Dendy3CTD/NeuroPaw/analysis_v6.md

# NeuroPaw v6 — Этап 0: анализ robodog_v3.blend

Скрипт: `scripts/v6_00_inventory.py`, сырой вывод: `analysis_v6_raw.txt`,
рендеры: `renders/v6_before_{front,side,top,iso}.png`.

## Что есть
- 87 объектов: 62 меша, 25 пустышек. Коллекции: Body (6), Electronics (6), Head (9),
  Leg_FL/FR/RL/RR (по 10), Rig (25). Арматуры нет, камеры и света нет, движок EEVEE.
  Единицы — метры, масштаб 1.
- 12 × MG996R на ногах: отведение (ось X, серва в корпусе), бедро (ось Y, в кронштейне),
  колено (в бедре, привод голени через качалку, тягу и рычаг, параллелограмм).
  Вал каждой сервы совпадает с осью сустава.
- Риг на пустышках: `*_shoulder → *_hip → *_knee`. Качалка копирует угол колена,
  тяга сделана через Stretch To. Ограничений хода нет.
- Стойка: бедро 44.7°, колено −84.8°. Стопы под осями бёдер на Z = 10 мм,
  пересечений между звеньями нет. Габарит 432 × 231 × 279 мм.
- Корпус 260×110×60 из 6 пластин с фаской. Электроника — коробки:
  2S 140×45×25, ESP32-S3, 1 × PCA9685, UBEC, IMU.
- Голова статичная: глаза GC9A01, камера IMX219, VL53L5CX, уши без привода.
- 14 простых Principled-материалов.

## Чего не хватает до 20 сервоприводов
| №  | Узел | В v3 |
|----|---|---|
| 01–12 | ноги | есть, но надо переименовать (RL/RR → BL/BR, `Servo_NN_*`) и детализировать |
| 13–14 | позвоночник pitch / yaw | нет: корпус цельный |
| 15–16 | шея pitch / yaw | нет: голова прикручена к крышке |
| 17 | челюсть | нет, морда цельная |
| 18–19 | уши | уши есть, но без серв |
| 20 | хвост | нет |

## Инженерные проблемы
1. **Валы несут изгиб.** Ни на одном суставе нет второй опоры. Бедро висит на валу
   сервы бедра консолью, у кронштейна плеча нет подшипника, ось рычага колена
   проходит сквозь щёки без подшипников.
2. **Мёртвая точка колена.** Механизм колена — параллелограмм. Он вырождается, когда
   нога выпрямлена (угол 0° — это край хода 0–130°). Нужен четырёхзвенник с разными
   плечами или смещённая фаза, чтобы угол передачи во всём ходе был не меньше 30°.
3. **Корпус мал.** Плечевая MG996R с ушками (54.5 мм) входит в корпус высотой 60
   с зазором 0.25 мм, а требование — 0.3 мм посадки. Туда же не помещаются
   Pi 5 с кулером, второй PCA9685, DC-DC, отсек батареи и узел позвоночника.
   Корпус придётся увеличить, см. вопрос 2.
4. Кронштейн сервы бедра держит её только сверху и спереди. Качалки нейлоновые,
   а не 25T алюминиевые. Нет упоров, термовставок, винтов, скруглений.
5. Сервы — коробка с цилиндром: нет шлицов, наклейки и выхода провода. Нет MG90S/SG90.
6. Нет проводов, кабельных каналов, выключателя, XT60, DC-DC.
7. `weight_report.txt` относится к v2, ошибка в моментах колена и бедра не исправлена.
   Массы v3 и центр масс не считались.

## Визуальные проблемы
- Всё собрано из коробок: оболочки и накладок нет, голова — куб, уши — пластинки.
- Нет панельных линий, крепежа, протектора, логотипа. Материалы-заглушки, EEVEE без
  света и камеры, рендер плоский.

---

# Изменение архитектуры (27.10.2026): 4 × ESP32-S3 + CAN

Jetson Orin Nano и Raspberry Pi 5 убраны. Документы обновлены: `project.txt`, `params.json`
(старый — `params_v3.json`, его читает `build_v3.py`).

## Платы
| Плата | Модуль | Где | Что подключено |
|---|---|---|---|
| ESP32_Body | ESP32-S3-DevKitC-1 N16R8, 63×25.4 мм | задняя секция, над АКБ | PCA9685 0x40 (сервы 01–14, 20), BNO085, INA226 (ток серв + напряжение АКБ), CAN-терминатор |
| ESP32_Brain | ESP32-S3-DevKitC-1 N16R8 | передняя секция, у дна | microSD 64 ГБ (SPI, лючок на левом боку), CAN |
| ESP32_Comms | XIAO ESP32S3 + FPC-антенна | передняя секция, под крышкой | Wi-Fi/BLE; антенна под крышкой из PETG, вдали от серво-жгутов |
| ESP32_Head | XIAO ESP32S3 Sense (OV2640, PDM-микрофон) | в голове за лицевой панелью | PCA9685 0x41 (сервы 15–19), MAX98357A, 2 кольца WS2812B, VL53L5CX, 3 × TTP223, CAN-терминатор |

**Голова: XIAO Sense + PCA9685, а не DevKitC и не прямой PWM.**
- Камера и микрофон уже стоят на плате. DevKitC (63×25 мм) не помещается за лицом
  вместе с камерой, а камеру к нему пришлось бы вести 16 проводами.
- У XIAO 11 GPIO. Уже заняты: I2C (2), CAN (2), I2S динамика (3), лента глаз (1),
  то есть 8. Пять PWM для серв не помещаются.
- PCA9685 сидит на той же шине I2C, что и ToF, ему не нужны лишние пины. Его PWM
  аппаратный и не дрожит, когда процессор занят камерой и Wi-Fi.
- Глаза — светодиодные кольца WS2812B на одном пине вместо двух дисплеев GC9A01:
  тем на SPI нужно 5–6 пинов.

**IMU** стоит в задней секции у узла позвоночника (x ≈ −31 мм). Центр масс по оценке
на x ≈ +2 мм, это сам узел позвоночника, а он подвижный. Поэтому IMU на ближайшей
жёсткой секции, и I2C не пересекает изгиб.

## Корпус: 270 × 120 × 70 мм вместо 300 × 120 × 75
- Две секции по 120 мм и зазор 30 мм под узел позвоночника.
  - Pitch: серва 13 в задней секции, ось Y на x = −27.
  - Yaw: серва 14 на вилке, ось Z на x = +18.
- Зазора 30 мм хватает на ±20° pitch и ±15° yaw: при yaw ±15° угол передней секции
  подходит к задней на ≈ 15 мм.
- Ширина 120: аккумулятор 67 мм встаёт между плечевыми сервами (оси ±45 мм).
- Высота 70: плечевая MG996R с ушками (54.5 мм) входит с зазором ≥ 0.3 мм, внутри 64 мм.
- Ось бедра на Z = 175, спина на 220 мм, как в v3. Расстояние между бёдрами 220 мм.
- Аккумулятор 2S 6000 мА·ч — сборка **2S2P 18650** (76×67×20, 200 г) в отсеке снизу
  задней секции. Обычная LiPo 2S 6000 (138×47×25) не помещается в секцию 120 мм.

## Предварительная оценка (`docs/estimate_v6_prelim.md`)
- Масса ≈ **2.59 кг**, центр масс по X ≈ **+2 мм**.
- ⚠ **Колени MG996R не тянут стойку на трёх ногах**: нужно 10.5 кг·см, есть 9.4,
  запас 0.9. Рекомендация — **DS3218MG** на 03/06/09/12, запас 1.9, посадка та же.
  Вставать нужно, ставя стопу между бедром и коленом (запас 2.0). Если ставить стопу
  под бедро, запас 1.0.
- Остальные суставы с запасом ≥ 1.7.
- ⚠ Пиковый ток серв ≈ **25.7 А** — на пределе UBEC 25 А. Вставать нужно с разносом
  по времени (ноги по очереди) или брать UBEC 30 А.
- ⚠ Логика 5 В: пик ≈ **2.8 А**, а не 1–1.5 А. Основной вклад — LED-глаза и динамик.
  Глаза нужно ограничить ≤ 30 % яркости, иначе DC-DC 5 В 5 А.
- Время работы: ходьба ≈ 41 мин, стоит ≈ 78 мин, лежит ≈ 5.8 ч.

## Обновлённый план
- **Этап 1.** Модель v6 с нуля по параметрам (`scripts/build_v6.py`, логика v3):
  - две секции и позвоночник, 20 сервоприводов в коллекции Servos/{MG996R,MG90S,SG90};
  - шея, голова с челюстью, уши, хвост;
  - платы с понятными именами в Electronics/{Body,Head,Brain,Comms,Power}.
- **Этапы 2–6** — как в плане выше. Добавляются:
  - цвет «управляющая плата» в Servo_map;
  - рендер `v6_nervous_system.png`;
  - документы `docs/nervous_system.md`, `servo_map.md` (столбец «плата»), `bom.md`.

---

# Этап 1 — итог (robodog_v6.blend)

Сборка: `blender --background --python scripts/build_v6.py`. Модули — `scripts/v6lib/`:
`layout` (размеры, оси, таблица серв), `servo` (модели), `rig` (арматура), `parts_*`,
`cable`, `checks`. Рендеры: `renders/v6_s1_*.png`, `renders/v6_servo_types.png`.

- **20 сервоприводов**: MG996R × 15, MG90S × 1, SG90 × 4, коллекции `Servos/<тип>`.
  У каждой сервы custom properties: №, тип, сустав, ход, плата, PCA9685, канал, момент,
  масса, `shaft_sign` (направление вала относительно оси кости).
- **Модель сервы**: корпус, ушки со щелью, купол редуктора, шлицевой вал (25T/20T/21T),
  наклейка, выход провода из трёх жил с изгибом. Цвет по типу.
- **Арматура `NeuroPaw_rig`**: 29 костей — 20 суставов + Root + 8 MCH для тяги колена.
  Ось кости — локальная Y = ось вала.
- **Корпус** из двух секций с окнами под узел позвоночника. Серва 13 (pitch) в задней
  секции, серва 14 (yaw) в вилке. Шея: 15 в основании на крышке, 16 на звене шеи.
  Челюсть 17, уши 18/19, хвост 20.
- **Электроника** в `Electronics/{Body,Brain,Comms,Head,Power,CAN}`:
  - платы ESP32_Body, ESP32_Brain, ESP32_Comms, ESP32_Head и CAN_transceiver_* × 4;
  - microSD_slot у люка на левом боку;
  - `CAN_bus_cable` — трубка, гнётся вместе с арматурой.
- **Проверки (стойка)**:
  - пересечений между деталями 0;
  - стопы на полу (низ Z = 0.5 мм), тяги не меняют длину;
  - угол передачи колена ≥ 25° на всём ходе 0–130°, мёртвой точки нет;
  - габарит 421 × 241 × 373 мм.

**Риски к этапам 3 и 5**
- Отведение внутрь: при −30° щека бедра упирается в боковую стенку корпуса.
- Бедро ±90°: кронштейн плеча и кронштейн сервы бедра ограничивают ход.

Реальные пределы измерю перебором поз на этапе 5 и поставлю упоры.

---

# Решение по коленям, электронике и питанию — статус (прервано лимитом)

**Сделано**
- `scripts/v6_knee_linkage.py` → `docs/knee_linkage.md`, `params.json["knee_linkage"]`.
  - Геометрия B: качалка 15 мм, рычаг 29 мм, тяга 55 мм, β = 38°, вал сервы на оси бедра.
  - Ход колена 65–130° при ходе сервы 155°.
  - Передача 2.09 в стойке, ≥ 1.93 на шаге. Угол передачи ≥ 31°.
  - Запас колена ≥ 1.9 во всех позах, включая рысь ×1.3 и вставание из «лежит».
  - Поза «сидит» по-собачьи (κ 145°) несовместима с передачей 1.8:
    - до 145° — только передача 1.46 при качалке 18 мм (вариант C2);
    - до 140° — передача 1.66.
    - Выбран вариант B; «сидит» — неглубокая посадка с упором таза + позвоночник.
- `params.json` переписан:
  - `servo_table` — 20 серв по новой таблице;
  - DS3235MG, MG996R 11 кг·см;
  - подшипники: 6802ZZ × 6, F625ZZ × 12;
  - электроника: Brain = XIAO Sense в голове, Senses = DevKitC в голове;
  - питание: P28A 5600 мА·ч, 2 × UBEC 20 А, DC-DC 5 А;
  - цепочка CAN: Senses — Brain — Comms — Body;
  - адреса I2C, заполнение 22 %.

**Осталось (в этом порядке)**
1. `v6lib/layout.py`:
   - брать таблицу серв из `params.json["servo_table"]`;
   - переименовать кости (13 yaw — ребёнок 14 pitch; 15 хвост, 16–20 голова);
   - SH_X = 129, HIP_Y0 = 70.
2. `servo.py` + `parts.py`: тип DS3235MG (тёмно-серый), коллекция Servos/DS3235MG.
3. `parts_leg.py`:
   - четырёхзвенник: драйвер угла качалки (simple expression atan2/acos по углу колена), тяга Stretch To;
   - Limit Rotation на костях;
   - подшипники (6802 в торцевой стенке, F625 на крышке сервы бедра и 2 × F625 в колене);
   - посадочное место под торсионную пружину.
4. `parts_body.py`:
   - стойка + 6802 для pitch, 6802 в днище вилки для yaw;
   - перекомпоновка: спереди UBEC_F, DC-DC, предохранители, MOSFET, IMU_2;
   - сзади UBEC_R, BMS, INA226, предохранитель 40 А, XT60 loop-key, IMU_1 x −70…−44.
5. `parts_head.py`:
   - XIAO Sense (Brain) x 160…175 + OV5640 + радиатор;
   - DevKitC (Senses) вдоль Y на месте бывшего PCA (x 116…142, z 300…313);
   - GC9A01 × 2, INMP441 × 2 по бокам, INA219, конденсатор, касание;
   - челюсть MG90S.
6. Трасса CAN Senses → Brain → шея → Comms → Body; отдельная силовая трасса через шею (правая сторона).
7. Расчёт массы и центра масс по объёмам, моменты для 20 суставов, токи по UBEC.
   Документы: servo_map, engineering, power, nervous_system, bom, sim_params.
8. Рендеры:
   - колено в крайних положениях;
   - позы «лежит» и «встаёт»;
   - голова в разрезе;
   - `v6_nervous_system.png`.
   Затем этап 2.

Выводы, которые уже ясны и войдут в отчёт:
- **Выводы платы «Органы чувств»:**
  - GPIO38 → 17: RGB-светодиод DevKitC-1 v1.1. GPIO48 тоже не использовать: светодиод на v1.0.
  - GPIO33–37 заняты octal-PSRAM N16R8.
  - 39–42 = JTAG: отладка только через встроенный USB-JTAG.
  - LEDC: 6 каналов из 8, 2 таймера — хватает.
- **Головы:** DevKitC 69 мм входит только поперёк головы (по Y).
- **Нейросети:** веса нейросетей «Мозга» хранить на microSD и грузить в PSRAM.
  Во флеш 8 МБ (OTA 2 × 3 МБ) веса не помещаются.
- **Питание:** главный выключатель — XT60 loop-key: 40-амперному тумблеру нет места в задней секции.
- **Датчик расстояния на шине «Тела»** в ТЗ указан, но его нет: ToF на шине «Органов чувств».
  Если нужен второй (например, обрыв под грудью) — VL53L1X 0x29, конфликта адресов нет.

---

# Статус 28.10 (после перерыва)

**Готово**
- Модель перестроена (`build_v6.py`):
  - 20 серв по новой таблице (14 MG996R, 1 DS3235MG, 2 MG90S, 3 SG90);
  - колено B через драйвер с точной формулой четырёхзвенника, тяги замыкаются во всех позах;
  - 19 подшипников (12 F625ZZ, 7 6802ZZ, в том числе шея);
  - чаша торсионной пружины;
  - две платы в голове, IMU_2, питание разнесено по секциям;
  - CAN и силовой жгут через шею (раздельно).
  - Пересечений: 0 в позах «стоит», «встаёт», «лежит», «высокая стойка» и в крайних положениях колена 65/130° (`scripts/v6_poses.py`).
- «Лежит» = нижнее положение, живот 77 мм над полом. Животом на пол — нельзя:
  бедру нужно ≈ 150°, а механически предел ≈ 138°. Описано в `docs/knee_linkage.md`.
- Расчёт по модели (`scripts/v6_calc.py`):
  - масса **2.56 кг**, ЦМ (−2.9, +0.5, 183) мм;
  - запасы: отведение 1.9, бедро 2.1, колено (рысь ×1.3) 1.7;
  - написаны docs: servo_map, engineering, power, sim_params.
  - Известная ошибка: формула сервы 17 (шея-поворот) считает голову дважды — исправить.

**Вариант задних колен (ждёт решения пользователя), масса 2.56 кг**

| Вариант | Ход κ | Передача стойка/шаг | Рысь | Рысь ×1.3 | Шаг 3 ноги | Ось бедра в нижнем положении |
|---|---|---|---:|---:|---:|---|
| B (все ноги) | 65–130° | 2.09 / ≥1.93 | 2.2 | 1.7 | 1.9 | 103 мм |
| Задние: качалка 18, рычаг 30, тяга 57, u_s −4 | 65–140° | 1.97 / ≥1.64 | 2.1 | 1.6 | 1.8 | 88 мм |
| Задние: качалка 18, рычаг 27, тяга 74, u_s −4 | 60–145° | 1.48 / ≥1.46 | 1.6 | 1.2 | 1.3 | 80 мм |

**Дальше (решения пользователя от 28.10)**
1. После решения по коленям — при необходимости параметры задних ног.
2. Лючок под XT60 loop-key.
3. nervous_system.md: флеш XIAO и бюджет PSRAM.
4. Датчик обрыва под грудью на шине «Тела».
5. Исправить формулу сервы 17; облегчение до ~2.3 кг; bom.md; рендеры (960×540); этап 2.

**28.10, продолжение — сделано**
- Облегчение:
  - ненагруженные стенки 2.4 мм, нагруженные щёки и пластины кронштейнов 3.2 мм;
  - голени профиль 14 мм, заполнение 20 %.
  - Масса **2.50 кг** (было 2.56). Покупные детали 1.55 кг неизменны; до 2.3 кг печать должна быть ≤ 750 г (сейчас 957 г) — нужны карманы и рёбра на этапе 4.
- Датчик обрыва VL53L1X 0x29 под грудью (шина «Тела», конфликтов адресов нет).
- Рамка `Rear_power_panel` на заднем торце: XT60 и loop-key снаружи, без разборки.
- Исправлена формула сервы 17 (запас 3.4). Все 20 суставов ≥ 1.5.
- Пересечений 0 во всех позах.

**Следующее:** `scripts/v6_docs.py` → `nervous_system.md` + `bom.md`; рендеры 960×540; ждём решения по задним коленям; этап 2.

**28.10 — сделано (продолжение)**
- `scripts/v6_docs.py`:
  - `docs/nervous_system.md`: платы, выводы всех 4 плат, адреса I2C, CAN ID, флеш XIAO, PSRAM 5.3/8 МБ, нагрев, офлайн/онлайн;
  - `docs/bom.md`: список покупок;
  - обновлён `project.txt`.
- `scripts/v6_render_set.py` (960×540): `v6_knee_65/130`, `v6_poses_lie`, `v6_poses_standup`, `v6_head_cutaway`, `v6_nervous_system`.

**Ждём:** решение по задним коленям (B везде или задние 65–140°, качалка 18 / рычаг 30 / тяга 57).
**Дальше:** этап 2 (подписи, Servo_map, разнесённый вид, легенда); финальные рендеры в конце.

**28.10 — новое решение пользователя (окончательный список покупок)**
Колени B везде + упор 131–132°; «сидит» — наклоном позвоночника; этап 2 не начинать.
План (отмечать по ходу):
1. [x] params.json: компоненты строго по смете (убрать XIAO, BNO085, VL53L1X, VL53L5CX, INA219, microSD, касания, радиатор, INA226 батареи)
2. [x] v6lib/boards.py: платы с отверстиями и разъёмами; HC-SR04 в груди; C3 под крышкой; 2 × GY-521; голова: «Мозг» S3-CAM у затылка, флешка под лючком, динамик в челюсти
3. [x] механика: 625ZZ везде (+ мост груди/кормы для отведения), пары на позвоночнике и шее, 51100 на повороте шеи (серва 17 ниже на 8 мм), MR683 × 2 челюсть, упор колена, TPU губы/зубы, место под контакты док-станции
4. [x] позы stand/sit/lie/standup + голова ±90°, поле HC-SR04
5. [x] v6_calc (масса, ЦМ, запасы, пружина колена), v6_docs (bom по смете, nervous, assumptions)
6. [x] рендеры 960×540: голова в разрезе, задняя секция сверху, nervous_system; отчёт

- 28.10: пункты 1–3 сделаны: build_v6 → 25 подшипников (22 × 625ZZ, 2 × MR683ZZ, 51100), стойка — 0 пересечений. Дальше пункт 4 (v6_poses.py).
- 28.10: пункт 4 сделан (v6_poses → docs/poses_v6.json): все позы 0 пересечений. Найдено: мёртвая точка тяги B = 130.04° (не 131–132) → упор 128.5°, ход колена 65–128°. v6_calc: 2.57 кг (+84 г оси M5, +16 г 51100), колено рысь 1.72, пружина 1.8 мм → 2.53; ЦМ внутри опоры (стоит +89, сидит +50 мм). Дальше: v6_docs (bom по смете, nervous, assumptions).
- 28.10 итог: булево вычитание чинено (use_self) — оболочка головы была порезана, пересобрано. Масса 2.64 кг (ЦМ X −2), колено рысь 1.68 (пружина 1.8 мм → 2.43), шея наклон 4.2, поворот 3.5; все позы 0 пересечений; ЦМ внутри опоры (стоит +89, сидит +51 мм). bom.md обновлён, раздел «докупить». Рендеры: v6_head_cutaway, v6_rear_top, v6_nervous_system.
**Ждём решения:** пружина колена; OTG-кабель и шлейф 75 мм; упор 128.5° вместо 131–132 (мёртвая точка 130.04°). **Дальше:** этап 2 — только после «ок».

**28.10 — решения пользователя (упор 128.5°, пружины, OTG + провод 5 В, «Мозг» к морде, список покупок) — сделано**
- Пружина колена (v6_knee_spring.py): Ø2.0, OD 18, 6 витков, k 536 Н·мм/рад, натяг 25° при κ 65°; мин. запас 2.53 (рысь), все позы ≥ 1.8; чаша Ø22/Ø18.6; sim_params — stiffness/springref.
- «Мозг» за глазами (x 162–167), штатный шлейф 21 мм; флешка/лючок ниже на 2.5 мм; COM — через лючок; провод 5 В `OTG_5V_backup_wire`.
- bom.md: крепёж уточнён, качалки 25T — 16 шт., раздел «докупить». Масса 2.67 кг. Все позы 0 пересечений. Рендеры обновлены.
**Дальше: этап 2** (подписи, Shell/Servo_map, servo_map × 5, разнесённый вид, легенда, платы и CAN).

# Этап 2 — итог (28.10)
- `scripts/v6_stage2.py` (сохраняет blend):
  - коллекция `Labels`: 20 подписей серв «NN / тип», 4 подписи плат, 3 подписи CAN, легенда;
  - выноски привязаны к костям, подписи повёрнуты к камере;
  - слой `Servo_map`: оболочка полупрозрачная, сервы окрашены по управляющей плате (Тело — бирюза, Органы чувств — фиолетовый).
  - В обычном `ViewLayer` подписей нет.
- `scripts/v6_render_servo_map.py`:
  - `renders/v6_servo_map_{front,side,top,iso,back}.png` и `renders/v6_exploded.png`, 960×540;
  - развязка подписей: если подпись на виде наезжает на более близкую к камере, на этом виде она скрыта; скрипт проверяет, что каждая подпись видна хотя бы на одном виде.
  - Тонкость: `Labels` исключена в `ViewLayer`, поэтому на время карты коллекцию включаем, иначе матрицы подписей нулевые.
- `docs/servo_map.md`: столбец «Плата» есть.
- Известное: на виде спереди и сбоку пара подписей частично закрыта деталями (подписи не рисуются поверх геометрии).

**Дальше: этап 3** (инженерка) — ждёт «ок» пользователя.
