Dendy3CTD/NeuroPaw/docs/assumptions.md

# Допущения по размерам NeuroPaw v6

Размеры модулей — по даташитам и типовым платам. Где точных данных нет, в модели заложена посадка с зазором 1–2 мм; у объекта свойство `measure = True`. Перед печатью ложементов — замерить реальную деталь.

| Компонент | Принято в модели | Что замерить / примечание |
|---|---|---|
| ESP32 DevKit CH340, 38 выводов | 55 × 28 × 13 (с гребёнками) | 30-выводная 51 × 28 встаёт в то же место; крепёжных отверстий нет — ложемент + гнёзда PBS |
| ESP32-S3-DevKitC-1 N16R8 | 69 × 26 (продавцы: 63–69) | положение двух USB-C; отверстий нет — ложемент |
| ESP32-S3-CAM N16R8 | 64 × 27 × 7 без гребёнок | **замерить**: габарит, какой USB-C нативный, положение разъёма камеры (принят в центре платы — иначе штатного шлейфа 21 мм может не хватить), выводы CAN; модель камеры (принята OV2640) |
| ESP32-C3 SuperMini | 22.5 × 18 | сторона антенны |
| SN65HVD230 | 20 × 15, 2 × Ø2.2 | **замерить**: габарит, отверстия, где резистор 120 Ом |
| PCA9685 | 62.5 × 25.4, 4 × Ø2.5 (57.5 × 20.4) | по Adafruit; у клонов отверстия могут отличаться |
| GY-521 MPU-6050 | 21.2 × 16.4, 2 × Ø3 | задний IMU «имеется» — уточнить, что это GY-521 |
| HC-SR04 | 45 × 20 × 15, излучатели Ø16, центры ±13, 4 × Ø1.8 | **замерить** расстояние между излучателями (отверстия Ø17 в груди) |
| INA226 (CJMCU-226) | 20 × 25, 2 × Ø3, шунт 0.1 Ом | шунт 0.1 Ом → до 0.82 А; stall MG90S 0.7 А — хватает |
| MAX98357A | 18 × 19 | клеммник не впаивать |
| INMP441 | Ø14 | положение отверстия микрофона |
| GC9A01 1.28" | плата Ø38.6, стекло Ø35.6 × 2.1, хвостовик 12 × 7.5, толщина ≈ 4.5 | **замерить** плату и толщину; окна в морде Ø33 |
| Динамик 35 × 25 | 35 × 25 × 5, ушки с Ø2 | **замерить** толщину (лоток челюсти 8 мм) |
| Флешка 50 ГБ | 45 × 16 × 8 с разъёмом | **замерить**: окно лючка 19.6 × 19.6, под корпус флешки поперёк головы 33 мм |
| Гибкий OTG-кабель | угловой USB-C 12 × 9 × 7, гнездо 22 × 15 × 8 | нет в смете |
| Сервоприводы, 625ZZ, MR683ZZ, 51100 | по даташитам | посадка подшипников Ø D + 0.2 |
| Блоки питания (UBEC, BMS, DC-DC, аккумулятор) | габаритные блоки | не закуплено — место зарезервировано |
| Упор колена | грань под 128.5°, мёртвая точка тяги 130.04° | допуск печати ±0.3 мм ≈ ±1°: при сборке проверить, что упор срабатывает до мёртвой точки |
