Dendy3CTD/NeuroPaw/docs/estimate_v6_prelim.md

# NeuroPaw v6 — предварительная оценка (до модели)

Источник: `scripts/v6_estimate.py`, параметры — `params.json`.
Точные массы по геометрии — на этапе 3.

## Масса: **2.59 кг**, центр масс по X: **+1.7 мм** (0 = середина между бёдрами, + = к голове)

| Узел | г |
|---|---:|
| Ноги (4 шт.) | 1282 |
| Корпус, позвоночник, шея, голова, хвост | 883 |
| Электроника и провода | 420 |

<details><summary>Электроника по позициям</summary>

| Позиция | г | x, мм |
|---|---:|---:|
| ESP32_Body | 9.0 | -55 |
| ESP32_Brain | 9.0 | +65 |
| ESP32_Comms | 5.0 | +70 |
| ESP32_Head | 6.0 | +205 |
| CAN_transceivers | 8.0 | +30 |
| PCA9685_Body | 9.0 | -82 |
| PCA9685_Head | 9.0 | +190 |
| IMU | 3.0 | -31 |
| Power_monitor | 4.0 | -110 |
| UBEC_6V_25A | 35.0 | -113 |
| DCDC_5V_3A | 4.0 | -110 |
| Battery_2S | 200.0 | -82 |
| microSD_slot | 3.0 | +69 |
| Speaker | 10.0 | +190 |
| Eyes_LED | 6.0 | +215 |
| ToF | 2.0 | +235 |
| Touch | 3.0 | +200 |
| XT60_switch | 10.0 | -120 |
| Провода: 20 жгутов сервоприводов, CAN, силовые | 85.0 | -10 |

</details>

## Моменты в худших позах (кг·см, момент сервы при 6 В)

Стойка: ось бедра 175 мм, угол бедра 46.6°, плечо колена 80 мм. Три ноги: поднята FL, центр масс смещён на 10 мм в треугольник → FR 51%, BL 44%, BR 5% веса.

| № | Поза | Серво | Нужно | Есть | Запас | Примечание |
|---|---|---|---:|---:|---:|---|
| 03/06/09/12 | колено, 3 ноги | MG996R | 10.50 | 9.4 | 0.9 ⚠ | 1.31 кг × 8.0 см, высота бедра 175 мм |
|  | колено, 3 ноги, стойка выше на 25 мм | MG996R | 8.50 | 9.4 | 1.1 ⚠ | плечо 6.5 см |
|  | колено, 3 ноги — DS3218MG | DS3218MG | 10.50 | 20.0 | 1.9 | замена |
|  | колено, 4 ноги, стоит | MG996R | 5.17 | 9.4 | 1.8 |  |
|  | колено, вставание: стопа под бедром | MG996R | 9.24 | 9.4 | 1.0 ⚠ | бедро горизонтально, плечо 11 см, ×1.3 |
|  | колено, вставание: стопа между бедром и коленом | MG996R | 4.62 | 9.4 | 2.0 | плечо 5.5 см — так и надо вставать |
| 02/05/08/11 | бедро, вставание (та же стратегия) | MG996R | 4.62 | 9.4 | 2.0 |  |
|  | бедро, 3 ноги, стопа сдвинута на 40 мм | MG996R | 5.25 | 9.4 | 1.8 |  |
| 01/04/07/10 | отведение, 3 ноги | MG996R | 5.45 | 9.4 | 1.7 | стопа в 41.5 мм от оси отведения |
| 13 | позвоночник pitch, стоит | MG996R | 2.26 | 9.4 | 4.2 | изгиб в середине «балки» × 1.5 (шаг) |
| 14 | позвоночник yaw, рысь | MG996R | 1.20 | 9.4 | 7.8 | оценка: боковые силы стоп |
| 15 | шея pitch, голова вперёд + игрушка 50 г | MG996R | 1.80 | 9.4 | 5.2 | голова 0.17 кг × 7 см |
| 16 | шея yaw, шея наклонена 45° | MG90S | 0.34 | 2.2 | 6.4 | + инерция |
| 17 | челюсть: игрушка 50 г + сжатие | SG90 | 0.50 | 1.8 | 3.6 |  |
| 18/19 | ухо 8 г | SG90 | 0.02 | 1.8 | 90.0 |  |
| 20 | хвост 20 г | SG90 | 0.10 | 1.8 | 18.0 |  |

## Токи и время работы

- Сервоприводы, пик (вставание, 12 ног × 70 % stall + остальные): **25.7 А** при 6 В — UBEC 25 А.
- Логика 5 В: пик **2.77 А**, среднее 0.86 А — DC-DC 3 А.
- Аккумулятор: 44.4 Вт·ч, используем 80 % = 35.5 Вт·ч.
- ходьба: сервы 7.1 А → 52 Вт от батареи → **≈ 41 мин**
- стоит: сервы 3.4 А → 27 Вт от батареи → **≈ 78 мин**
- лежит, сервы держат минимум: сервы 0.2 А → 6 Вт от батареи → **≈ 349 мин**
