Dendy3CTD/NeuroPaw/docs/nervous_system.md

# Нервная система NeuroPaw v6

ESP32 + 2 × ESP32-S3 + ESP32-C3 на шине CAN (TWAI есть во всех трёх семействах). Источник: `params.json` (`electronics`, `servo_table`, `i2c`, `can`), генератор — `scripts/v6_docs.py`.

## Платы

| Плата | Модуль | Где | Отвечает за |
|---|---|---|---|
| Органы чувств | ESP32-S3-DevKitC-1 N16R8 (69×26) | голова, плашмя поперёк, z 301…314 | слух, голос, глаза-экраны, ток челюсти, сервы 16–20 |
| Мозг | ESP32-S3-CAM N16R8 + камера OV2640 (64×27, замерить) | голова, вертикально за глазами (x 162…167) | зрение, память (флешка), поведение |
| Связь с миром | ESP32-C3 SuperMini (22.5×18) | передняя секция, под крышкой у левого борта | Wi-Fi, облачная LLM; **необязательна** |
| Тело | ESP32 DevKit CH340 (ESP32-WROOM-32), 38 выводов (55×28) | задняя секция, на полке над аккумулятором | сервы 01–15 (PCA9685), баланс по 2 × MPU-6050, HC-SR04, батарея |

## Шина CAN

```
Органы чувств [120 Ом] ── Мозг ══ шея (витая пара, петля ±90°) ══ Связь ══ позвоночник ══ Тело [120 Ом]
```
- 500 кбит/с, 4 × SN65HVD230 (3.3 В) — по одному у каждой платы.
- На модулях стоит 120 Ом — **снять** на «Мозге» и «Связи», оставить на «Органах чувств» и «Теле».
- CAN по левой стороне шеи и позвоночника, силовой жгут 6 В/5 В — по правой с петлёй за осью наклона шеи (ось — болт M5, полой оси нет). Объекты `CAN_bus_cable`, `Power_head_harness`.
- Загрузка шины: ≈ 400 кадров/с × 110 бит ≈ 44 кбит/с (≈ 9 %).

## Выводы

### ESP32_Body — «Тело» (ESP32 DevKit CH340, ESP32-WROOM-32, задняя секция)

| Функция | GPIO | Примечание |
|---|---|---|
| CAN TX / RX | 27 / 26 | SN65HVD230, 120 Ом оставить (крайняя плата) |
| I2C SDA / SCL | 21 / 22 | PCA9685 0x40, MPU-6050 0x68 (задний), 0x69 (передний) |
| PCA9685 OE | 33 | подтяжка 10 кОм к 3.3 В: при загрузке выходы выключены (мягкий старт) |
| HC-SR04 Trig / Echo | 32 / 35 | Echo 5 В → делитель 1 кОм / 2 кОм; 35 — только вход |
| MPU INT задний / передний | 34 / 39 | только входы |
| Напряжение батареи | 36 (VP, ADC1) | делитель 100 кОм / 33 кОм: 8.4 В → 2.08 В |
| MOSFET ветки (питание, не закуплено) | 16, 17, 18, 19 | UBEC-П ноги, UBEC-П голова, UBEC-З ноги, UBEC-З позвоночник+хвост |
| Светодиод | 2 | на плате; GPIO2 — strapping, только выход |
| USB-UART (CH340) | 1 / 3 | прошивка; плата доступна под крышкой задней секции |
| Резерв | 4, 13, 14, 23, 25 | 4 — датчик док-станции (позже) |

### ESP32_Senses — «Органы чувств» (ESP32-S3-DevKitC-1 N16R8, голова)

| Функция | GPIO | Примечание |
|---|---|---|
| CAN TX / RX | 15 / 16 | SN65HVD230, 120 Ом оставить (крайняя плата) |
| I2C SDA / SCL | 8 / 9 | INA226 0x40 — ток сервы челюсти |
| INA226 ALERT | 1 | превышение тока хвата — прерывание |
| I2S BCLK / WS | 4 / 5 | общие для микрофонов и усилителя |
| I2S DIN | 6 | 2 × INMP441: L/R по выводу L/R — стерео, направление на звук |
| I2S DOUT | 7 | MAX98357A → динамик 35×25 в челюсти |
| SPI SCK / MOSI / DC / RST | 12 / 11 / 13 / 47 | 2 × GC9A01 |
| CS левый / правый глаз | 10 / 14 |  |
| Подсветка экранов | 21 | LEDC ~20 кГц, ≤ 50 % |
| Серва 16 шея наклон | 17 | LEDC 50 Гц; на v1.1 GPIO38 — RGB-светодиод (на v1.0 он на 48), поэтому 17; запасной — 18 |
| Серва 17 шея поворот | 39 | LEDC; 39–42 — JTAG: отладка только через USB-JTAG |
| Серва 18 челюсть | 40 | LEDC; питание через INA226 — рефлекс хвата локально |
| Серва 19 / 20 уши | 41 / 42 | LEDC |
| USB-C | 19 / 20 | прошивка через окно в левом борту головы |
| Резерв | 2, 18, 48 (v1.1) / 38 (v1.0) |  |

### ESP32_Brain — «Мозг» (ESP32-S3-CAM N16R8, голова, за глазами)

| Функция | GPIO | Примечание |
|---|---|---|
| Камера DVP (OV2640) | XCLK 15, SIOD 4, SIOC 5, D0–D7 11 / 9 / 8 / 10 / 12 / 18 / 17 / 16, VSYNC 6, HREF 7, PCLK 13 | типовая разводка ESP32-S3-CAM — **сверить со схемой купленной платы** |
| USB-хост (флешка) | 19 / 20 | USB-C «USB»/«OTG» — нативный USB; гибкий OTG-кабель к гнезду под лючком |
| CAN TX / RX | 21 / 14 | SN65HVD230, 120 Ом снять; выводы сверить с платой |
| USB-C «COM» | через CH343 (UART0 43 / 44) | прошивка и лог — через лючок на правом боку головы |
| Резерв | 1, 2, 38–42, 47 | 2 или 48 — светодиод на части плат; 3, 45, 46 — strapping |

### ESP32_Comms — «Связь с миром» (ESP32-C3 SuperMini, передняя секция)

| Функция | GPIO | Примечание |
|---|---|---|
| CAN TX / RX | 4 / 5 | SN65HVD230, 120 Ом снять |
| Антенна | керамическая на плате | плата под крышкой (PETG) у левого борта; силовые провода — по правому |
| USB-C | 18 / 19 (USB-Serial-JTAG) | прошивка — снять крышку передней секции |
| Светодиод / BOOT | 8 / 9 | strapping |

ESP32-S3 N16R8: GPIO26–32 — флеш, **GPIO33–37 — octal PSRAM**, не использовать; 0, 3, 45, 46 — strapping. ESP32 (WROOM-32): GPIO6–11 — флеш; 0, 2, 5, 12, 15 — strapping (**12 не подтягивать к 3.3 В** — напряжение флеша); 34–39 — только входы. ESP32-C3: 2, 8, 9 — strapping.

LEDC «Органов чувств»: 5 серв (таймер 0, 50 Гц, 14 бит) + подсветка (таймер 1, ~20 кГц) = **6 каналов из 8, 2 таймера из 4**.

## Адреса I2C

### ESP32_Body — SDA GPIO21 / SCL GPIO22, 400 кГц; подтяжки: на модулях GY-521 4.7 кОм × 2 + PCA9685 10 кОм ≈ 2 кОм — внешних не нужно

| Адрес | Устройство |
|---|---|
| 0x40 | PCA9685 |
| 0x68 | MPU-6050 задний (AD0 = 0) |
| 0x69 | MPU-6050 передний (AD0 = 1), витая пара через позвоночник ≤ 20 см |
| 0x70 | PCA9685 All-Call (не занимать) |

### ESP32_Senses — SDA GPIO8 / SCL GPIO9, 400 кГц; подтяжки: на модуле INA226

| Адрес | Устройство |
|---|---|
| 0x40 | INA226 — ток сервы челюсти (A0 = A1 = GND) |

Конфликтов нет: две MPU-6050 различаются выводом AD0 (задний — на GND, передний — на 3.3 В). Передний IMU — витая пара SDA/GND и SCL/GND через позвоночник ≤ 20 см; при сбоях — 100 кГц.

## CAN-сообщения (первое приближение, 11-битные ID: меньше — важнее)

| ID | Кто → кому | Содержимое | Частота |
|---|---|---|---|
| 0x001 | любой → все | E-STOP: выключить ветки серв | событие |
| 0x002 | Тело → все | Падение / поднят с пола | событие |
| 0x003 | Тело → все | Батарея критически разряжена | событие |
| 0x011…0x014 | каждая плата | Heartbeat: состояние, аптайм, температура (11 Органы, 12 Мозг, 13 Связь, 14 Тело) | 2 Гц |
| 0x100 / 0x101 | Тело → Мозг | IMU задний / передний: крен, тангаж (int16 × 0.01°), угловые скорости | 100 Гц |
| 0x110 | Тело → все | Батарея: напряжение (АЦП), заряд % | 5 Гц |
| 0x120 | Тело → Мозг | Контакт стоп (по позе), фаза походки, поза | 20 Гц |
| 0x130 | Тело → Мозг | HC-SR04: расстояние до препятствия впереди | 15 Гц |
| 0x200 | Мозг → Тело | Команда походки: vx, vy (мм/с), wz (мрад/с), режим | 50 Гц |
| 0x201 | Мозг → Тело | Поза: стоит / сидит / лежит / встать / дай лапу | событие |
| 0x202 | Мозг → Тело | Позвоночник и хвост: цели, скорость | 20 Гц |
| 0x300 | Органы → Мозг | Имя услышано: уверенность, направление на звук (°) | событие |
| 0x301 | Органы → Мозг | Команда: id из 10–15, уверенность | событие |
| 0x302 | Органы → Мозг | Звук: хлопок / громко / лай, направление | событие |
| 0x305 | Органы → Мозг | GRIP held / lost (рефлекс хвата по INA226 — локально) | событие |
| 0x380 | Мозг → Органы | Выражение глаз (id анимации), моргание | событие |
| 0x381 | Мозг → Органы | Звук: id фразы / лая | событие |
| 0x382 | Мозг → Органы | Цели головы: шея наклон/поворот, уши, челюсть | 20 Гц |
| 0x400 / 0x401 | Мозг ↔ Связь | Запрос / ответ облачной LLM (ISO-TP, текст) | по запросу |
| 0x410 | Связь → Мозг | Wi-Fi: есть сеть, RSSI, облако доступно | 1 Гц |

## Флешка на «Мозге» (USB-хост)

1. **Какой разъём.** На типовой ESP32-S3-CAM два USB-C: «USB» (или «OTG») — нативный USB ESP32-S3 на GPIO19/20, умеет режим хоста; «COM» — через мост CH343/CH340, только UART. Флешка — только в «USB». Подпись и разводку **сверить по купленной плате**.
2. **5 В на флешку.** Обычно VBUS разъёма подключён к шине 5 В через диод (питание платы от USB), поэтому при питании платы с вывода 5 В на флешку напряжение **не выходит**. Варианты: перемычка «USB-OTG» / «5V OUT», если есть на плате (у DevKitC-1 такая есть); иначе — OTG-кабель с отдельным проводом 5 В от DC-DC (ток флешки ≤ 0.2 А). Проверка: питать плату с вывода 5 В и мерить VBUS на разъёме «USB».
3. **Скорость.** USB 1.1 Full Speed, ≈ 0.8–1 МБ/с: веса ≈ 2.4 МБ грузятся за ≈ 3 с.
4. **Место.** Жёсткий переходник 24 мм + флешка 45 мм = 69 мм от торца платы, а от разъёма до борта головы 12 мм — **не помещается**. В модели: угловой штекер USB-C, гибкий OTG-кабель 10 см, гнездо USB-A закреплено в голове, флешка лежит поперёк головы и вынимается через лючок на правом боку (окно 19.6 × 19.6, сечение флешки 16 × 7). Жёсткий переходник из сметы — для отладки на столе.
5. **Запасной вариант питания флешки** (если на «USB» нет 5 В): провод 5 В (AWG26, красный) от ветки DC-DC 5 В в голове (у конденсатора `Cap_head_2200uF`) к VBUS гнезда USB-A, GND — общий. В модели — `OTG_5V_backup_wire`; на плате ничего не перепаиваем, VBUS разъёма «USB» при этом не соединять с 5 В напрямую (диод на плате защищает от встречного тока).

## Нейросети и память

| Плата | Сети | Где лежат веса |
|---|---|---|
| Тело (WROOM-32, 4 МБ флеш, 520 КБ SRAM, без PSRAM) | ходьба (MLP int8); вставание после падения; тип пола по IMU; аномалии серв | ≈ 0.2 МБ во флеше, арена ≤ 100 КБ в SRAM — 50 Гц |
| Органы чувств (N16R8) | имя (wake word); 10–15 команд (KWS, свой русский датасет); звуки; направление на звук (GCC-PHAT, не сеть) | ≈ 1 МБ во флеше; PSRAM: аудио-буферы 64 КБ, кадры экранов 2 × 115 КБ |
| Мозг (N16R8) | лица; хозяин; игрушка; поведение; привычки | основное — флешка 50 ГБ → PSRAM при старте; копия во флеше 16 МБ |

### Флеш «Мозга» (16 МБ)

| Раздел | Размер | Назначение |
|---|---|---|
| nvs | 24 КБ | настройки, калибровка |
| otadata | 8 КБ |  |
| phy_init | 4 КБ |  |
| app0 (ota_0) | 4 МБ | прошивка «Мозга» (камера, USB-хост MSC, ESP-DL) |
| app1 (ota_1) | 4 МБ | обновление по воздуху / по CAN |
| coredump | 64 КБ | разбор сбоев |
| storage (LittleFS) | ≈ 7.9 МБ | копия весов сетей (≈ 2.4 МБ), конфиг, база лиц — старт без флешки |

С 16 МБ веса (≈ 2.4 МБ) помещаются и во флеш: основное хранилище — флешка (обновления, дневник, архив кадров), копия во флеше — чтобы «Мозг» стартовал, если флешка не определилась.

### PSRAM «Мозга» (8 МБ)

| Потребитель | МБ |
|---|---:|
| Кадры OV2640: 2 × QVGA RGB565 + 2 × JPEG для архива | 0.50 |
| Детектор лиц (ESP-DL, веса + активации) | 0.90 |
| Узнавание хозяина (MobileFaceNet int8, веса + активации) | 1.60 |
| Детектор игрушки 96×96 | 0.40 |
| Выбор поведения (MLP по шести чувствам) | 0.05 |
| Распорядок и привычки | 0.10 |
| База лиц: 200 эмбеддингов × 512 Б | 0.10 |
| Буферы USB MSC / FAT, лог дневника | 0.15 |
| Резерв кучи | 1.50 |
| **Итого** | **5.30** из 8 |

### Камера и нагрев «Мозга»

«Мозг» стоит вертикально за глазами: разъём камеры в центре платы, до камеры ≈ 12 мм — **хватает штатного шлейфа ~21 мм** (длинный DVP-шлейф не нужен). Если при сборке шлейф всё же окажется длиннее и появятся помехи — снижаем XCLK камеры с 20 до 10 МГц.
ESP32-S3 с камерой при постоянной работе — 60–70 °C. Радиатора в смете нет: между модулем и экранами воздушный зазор ≈ 10 мм, над ним в крышке головы 7 прорезей 3 × 7 мм, воздух снизу — через окно челюсти (тяга вверх). При перегреве снижать частоту кадров.

## Без интернета и с платой «Связь»

| Работает без интернета (и без платы «Связь») | Только с «Связью» и интернетом |
|---|---|
| ходьба, баланс, рефлексы, вставание | свободная речь (Whisper API) |
| имя и 10–15 команд, звуки, направление на звук | новые сценарии через LLM (Groq, GigaChat) |
| лица, хозяин, игрушка, препятствия (HC-SR04) | обновления по Wi-Fi |
| чувства, привычки, дневник на флешке | — |
