Dendy3CTD/NeuroPaw/docs/power.md

# Питание NeuroPaw v6

Источник: `params.json["power"]`, `scripts/v6_calc.py`.

## Схема

```
2S2P Molicel P28A (7.2 В, 5600 мА·ч, 50 А) + BMS 2S 40 А
  └─ предохранитель 40 А ─ XT60 loop-key (главный выключатель); напряжение — делитель 100к/33к → GPIO36 «Тела»
      ├─ предохр. 25 А ─ UBEC-П 6 В 20 А ─ MOSFET ─ передние ноги 01–06
      │                                    └ MOSFET ─ (шея) 16, 17, челюсть 18 через INA226, уши 19, 20
      ├─ предохр. 25 А ─ UBEC-З 6 В 20 А ─ MOSFET ─ задние ноги 07–12, позвоночник 13, 14, хвост 15
      └─ предохр. 5 А ─ DC-DC 5 В 5 А ─ ESP32 + 2 × ESP32-S3 + ESP32-C3, экраны, HC-SR04 (≤ 50 %), звук, датчики
Земля — звездой на минусе батареи. 2200 мкФ Low-ESR: у PCA9685, на выходе UBEC-П, в голове.
Мягкий старт: OE PCA9685 подтянут к 3.3 В (выходы выключены при загрузке),
  «Тело» включает ветки MOSFET по очереди с паузой ~200 мс.
```

## Токи сервоприводов (6 В)

| Ветка | Сервы | Все в stall, А | Пик (вставание), А | Ходьба, А | Стоит, А | UBEC |
|---|---|---:|---:|---:|---:|---|
| UBEC_F | 01, 02, 03, 04, 05, 06, 16, 17, 18, 19, 20 | 20.2 | 12.1 | 3.7 | 1.8 | 20 А ✓ |
| UBEC_R | 07, 08, 09, 10, 11, 12, 13, 14, 15 | 21.1 | 12.3 | 3.4 | 1.7 | 20 А ✓ |

Пик — ноги 70 % stall, остальные 30 %. «Все в stall» — заклинивание всех серв ветки одновременно: UBEC уходит в защиту раньше, чем сгорит предохранитель 25 А.

## Логика 5 В

Пик 2.26 А, среднее 0.77 А — DC-DC 5 А с запасом.

## Батарея

2S2P Molicel P28A: 40.3 Вт·ч, используем 80 % = 32.3 Вт·ч. Ток пакета считаем при 6.8 В под нагрузкой, КПД преобразователей 90 %.

| Режим | Сервы, А | Логика, А | Мощность, Вт | Ток батареи, А | Время |
|---|---:|---:|---:|---:|---:|
| Пик (вставание) | 24.4 | 2.26 | 175 | 25.8 | — |
| Все сервы в stall | 41.3 | 2.26 | 288 | 42.4 | — |
| Ходьба | 7.2 | 0.77 | 52 | 7.7 | 37 мин |
| Стоит | 3.4 | 0.77 | 27 | 4.0 | 72 мин |
| Лежит, сервы без нагрузки | 0.2 | 0.77 | 6 | 0.8 | 346 мин |

P28A: 25 А на ячейку → пакет 2P = 50 А. BMS 40 А и предохранитель 40 А: пик вставания 26 А проходит; одновременный stall всех серв (42 А) — выше 40 А: сработает защита BMS.
