Dendy3CTD/NeuroPaw/docs/servo_map.md

# Карта сервоприводов NeuroPaw v6

Источник: `params.json["servo_table"]`, расчёт — `scripts/v6_calc.py` по модели `robodog_v6.blend` (масса 2.67 кг). Момент — при 6 В.
Ход колена дан как сгибание κ (0 = прямая нога); кость колена: φ = −κ. Колено через тягу: «нужно» — момент на валу сервы (уже делённый на передачу).

| № | Объект / кость | Сустав | Тип | Плата | Канал | Питание | Ход | Нужно, кг·см | Есть | Запас | Худшая поза |
|---|---|---|---|---|---|---|---|---:|---:|---:|---|
| 01 | `Servo_01_FL_abduction` | ПЛ отведение | MG996R | ESP32_Body | PCA9685 0x40 ch0 | UBEC_F | -30…30° | 6.06 | 11.0 | **1.8** | 3 ноги: 51 % веса × смещение стопы от оси отведения |
| 02 | `Servo_02_FL_hip` | ПЛ бедро | MG996R | ESP32_Body | PCA9685 0x40 ch1 | UBEC_F | -90…90° | 5.45 | 11.0 | **2.0** | 3 ноги, стопа вынесена на 40 мм (вставание: 0.25·m·1.3 × 33 мм — меньше) |
| 03 | `Servo_03_FL_knee` | ПЛ колено (через тягу) | MG996R | ESP32_Body | PCA9685 0x40 ch2 | UBEC_F | κ 65…128° | 4.34 | 11.0 | **2.5** | с пружиной 2.0 мм: худшая поза — рысь, 2 ноги ×1.3 (все позы — engineering.md) |
| 04 | `Servo_04_FR_abduction` | ПП отведение | MG996R | ESP32_Body | PCA9685 0x40 ch3 | UBEC_F | -30…30° | 6.06 | 11.0 | **1.8** | 3 ноги: 51 % веса × смещение стопы от оси отведения |
| 05 | `Servo_05_FR_hip` | ПП бедро | MG996R | ESP32_Body | PCA9685 0x40 ch4 | UBEC_F | -90…90° | 5.45 | 11.0 | **2.0** | 3 ноги, стопа вынесена на 40 мм (вставание: 0.25·m·1.3 × 33 мм — меньше) |
| 06 | `Servo_06_FR_knee` | ПП колено (через тягу) | MG996R | ESP32_Body | PCA9685 0x40 ch5 | UBEC_F | κ 65…128° | 4.34 | 11.0 | **2.5** | с пружиной 2.0 мм: худшая поза — рысь, 2 ноги ×1.3 (все позы — engineering.md) |
| 07 | `Servo_07_BL_abduction` | ЗЛ отведение | MG996R | ESP32_Body | PCA9685 0x40 ch6 | UBEC_R | -30…30° | 6.06 | 11.0 | **1.8** | 3 ноги: 51 % веса × смещение стопы от оси отведения |
| 08 | `Servo_08_BL_hip` | ЗЛ бедро | MG996R | ESP32_Body | PCA9685 0x40 ch7 | UBEC_R | -90…90° | 5.45 | 11.0 | **2.0** | 3 ноги, стопа вынесена на 40 мм (вставание: 0.25·m·1.3 × 33 мм — меньше) |
| 09 | `Servo_09_BL_knee` | ЗЛ колено (через тягу) | MG996R | ESP32_Body | PCA9685 0x40 ch8 | UBEC_R | κ 65…128° | 4.34 | 11.0 | **2.5** | с пружиной 2.0 мм: худшая поза — рысь, 2 ноги ×1.3 (все позы — engineering.md) |
| 10 | `Servo_10_BR_abduction` | ЗП отведение | MG996R | ESP32_Body | PCA9685 0x40 ch9 | UBEC_R | -30…30° | 6.06 | 11.0 | **1.8** | 3 ноги: 51 % веса × смещение стопы от оси отведения |
| 11 | `Servo_11_BR_hip` | ЗП бедро | MG996R | ESP32_Body | PCA9685 0x40 ch10 | UBEC_R | -90…90° | 5.45 | 11.0 | **2.0** | 3 ноги, стопа вынесена на 40 мм (вставание: 0.25·m·1.3 × 33 мм — меньше) |
| 12 | `Servo_12_BR_knee` | ЗП колено (через тягу) | MG996R | ESP32_Body | PCA9685 0x40 ch11 | UBEC_R | κ 65…128° | 4.34 | 11.0 | **2.5** | с пружиной 2.0 мм: худшая поза — рысь, 2 ноги ×1.3 (все позы — engineering.md) |
| 13 | `Servo_13_spine_yaw` | позвоночник вбок | MG996R | ESP32_Body | PCA9685 0x40 ch12 | UBEC_R | -15…15° | 3.45 | 11.0 | **3.2** | рысь: боковые силы передних стоп 15 % веса × 86 мм до оси |
| 14 | `Servo_14_spine_pitch` | позвоночник вверх-вниз | DS3235MG | ESP32_Body | PCA9685 0x40 ch13 | UBEC_R | -20…20° | 2.10 | 32.0 | **15.2** | изгиб в узле при стойке 1.40 кг·см × 1.5 (шаг) |
| 15 | `Servo_15_tail` | хвост | SG90 | ESP32_Body | PCA9685 0x40 ch14 | UBEC_R | -60…60° | 0.03 | 1.8 | **54.7** | хвост горизонтально × 1.5 (размах) |
| 16 | `Servo_16_neck_pitch` | шея наклон | MG996R | ESP32_Senses | GPIO17 (LEDC; GPIO38 занят RGB-светодиодом на DevKitC-1 v1.1) | UBEC_F | -30…45° | 2.68 | 11.0 | **4.1** | голова+шея 295 г, наклон +45°, + игрушка 50 г |
| 17 | `Servo_17_neck_yaw` | шея поворот | MG90S | ESP32_Senses | GPIO39 (LEDC) | UBEC_F | -90…90° | 0.70 | 2.2 | **3.2** | шея наклонена 45°: тяжесть головы относительно оси поворота + разгон |
| 18 | `Servo_18_jaw` | челюсть | MG90S | ESP32_Senses | GPIO40 (LEDC) | UBEC_F через INA226 | 0…30° | 0.47 | 2.2 | **4.7** | челюсть + игрушка 50 г на 35 мм + удержание (INA226 ограничивает) |
| 19 | `Servo_19_ear_L` | ухо левое | SG90 | ESP32_Senses | GPIO41 (LEDC) | UBEC_F | -45…45° | 0.01 | 1.8 | **226.2** | ухо горизонтально × 2 (быстрый взмах) |
| 20 | `Servo_20_ear_R` | ухо правое | SG90 | ESP32_Senses | GPIO42 (LEDC) | UBEC_F | -45…45° | 0.01 | 1.8 | **226.2** | ухо горизонтально × 2 (быстрый взмах) |

Все суставы с запасом ≥ 1.5.
