Dendy3CTD/NeuroPaw/docs/sim_params.md

# Параметры для MuJoCo (NeuroPaw v6)

Источник: `scripts/v6_calc.py` по `robodog_v6.blend`. Система координат: X вперёд, Y влево, Z вверх; оси звена совпадают с мировыми в позе покоя (ноги прямые). ЦМ звена — от оси его сустава, мм. Инерция — относительно ЦМ звена, кг·м² (оценка по точечным массам деталей, без собственной инерции деталей — занижение у крупных деталей корпуса).

## Приводы

| Тип | Момент @6 В, Н·м | Скорость, рад/с | Люфт, ° | Мёртвая зона, мкс | Stall, А |
|---|---:|---:|---:|---:|---:|
| MG996R | 1.08 | 7.5 | 1.0 | 5 | 2.5 |
| DS3235MG | 3.14 | 8.1 | 0.5 | 3 | 3.0 |
| MG90S | 0.22 | 13.1 | 1.5 | 5 | 0.7 |
| SG90 | 0.18 | 10.5 | 2.0 | 10 | 0.65 |

## Колено

Привод через четырёхзвенник: r1 15.0 мм, r2 29.0 мм, тяга 55.0 мм. Передача нелинейная, таблица κ → (угол сервы, передача) — `docs/knee_linkage.md`; в стойке 2.09, на шаге ≥ 1.94. Ход κ 65…128° (кость: -128…-65°), упор 128.5°, мёртвая точка тяги 130.04°. В MuJoCo: joint колена с `gear` по таблице или `ctrlrange` сервы + tendon/таблица.

## Звенья

| Звено (кость) | Масса, г | ЦМ от оси, мм | Ixx | Iyy | Izz |
|---|---:|---|---:|---:|---:|
| `Root` | 786.9 | (-11.5, +1.1, -5.9) | 6.73e-04 | 9.60e-04 | 1.22e-03 |
| `Servo_01_FL_abduction` | 97.2 | (-11.4, +37.5, +11.1) | 4.97e-05 | 1.24e-05 | 5.27e-05 |
| `Servo_02_FL_hip` | 117.1 | (+1.5, +6.5, -54.5) | 6.64e-05 | 4.76e-05 | 2.32e-05 |
| `Servo_03_FL_knee` | 36.6 | (+1.6, -1.9, -30.5) | 4.28e-05 | 3.92e-05 | 4.76e-06 |
| `Servo_04_FR_abduction` | 97.2 | (-11.2, -37.5, +11.1) | 4.97e-05 | 1.22e-05 | 5.24e-05 |
| `Servo_05_FR_hip` | 117.1 | (+1.3, -6.5, -54.5) | 6.64e-05 | 4.76e-05 | 2.33e-05 |
| `Servo_06_FR_knee` | 36.6 | (+1.6, +1.9, -30.5) | 4.28e-05 | 3.92e-05 | 4.76e-06 |
| `Servo_07_BL_abduction` | 97.2 | (+11.2, +37.5, +11.1) | 4.97e-05 | 1.22e-05 | 5.24e-05 |
| `Servo_08_BL_hip` | 117.1 | (+1.5, +6.5, -54.5) | 6.64e-05 | 4.76e-05 | 2.32e-05 |
| `Servo_09_BL_knee` | 36.6 | (+1.6, -1.9, -30.5) | 4.28e-05 | 3.92e-05 | 4.76e-06 |
| `Servo_10_BR_abduction` | 97.2 | (+11.4, -37.5, +11.1) | 4.97e-05 | 1.24e-05 | 5.27e-05 |
| `Servo_11_BR_hip` | 117.1 | (+1.3, -6.5, -54.5) | 6.64e-05 | 4.76e-05 | 2.33e-05 |
| `Servo_12_BR_knee` | 36.6 | (+1.6, +1.9, -30.5) | 4.28e-05 | 3.92e-05 | 4.76e-06 |
| `Servo_13_spine_yaw` | 450.1 | (+73.4, +1.6, +5.3) | 7.23e-04 | 6.54e-04 | 7.84e-04 |
| `Servo_14_spine_pitch` | 120.3 | (+35.3, -2.2, -3.2) | 2.32e-05 | 4.55e-05 | 4.20e-05 |
| `Servo_15_tail` | 8.4 | (-26.3, +7.1, +5.9) | 0.00e+00 | 0.00e+00 | 0.00e+00 |
| `Servo_16_neck_pitch` | 68.0 | (-2.4, -3.5, +27.3) | 2.72e-05 | 2.09e-05 | 7.15e-06 |
| `Servo_17_neck_yaw` | 201.8 | (+34.2, -1.8, +41.1) | 8.56e-05 | 9.69e-05 | 1.25e-04 |
| `Servo_18_jaw` | 18.3 | (+21.9, -1.3, -8.1) | 4.69e-07 | 8.37e-07 | 1.12e-06 |
| `Servo_19_ear_L` | 3.4 | (-3.0, +3.3, +11.0) | 3.13e-18 | 3.91e-18 | 7.82e-19 |
| `Servo_20_ear_R` | 3.4 | (-3.0, -3.3, +11.0) | 3.13e-18 | 3.91e-18 | 7.82e-19 |

## Оси суставов (поза покоя, мм)

| Кость | Точка оси | Ось | Ход, ° |
|---|---|---|---|
| `Servo_01_FL_abduction` | (129.0, 45.0, 175.0) | (1, 0, 0) | -30…30 |
| `Servo_02_FL_hip` | (110.0, 89.5, 175.0) | (-1, 0, 0) | -90…90 |
| `Servo_03_FL_knee` | (110.0, 89.5, 65.0) | (0, 1, 0) | -128…-65 |
| `Servo_04_FR_abduction` | (129.0, -45.0, 175.0) | (1, 0, 0) | -30…30 |
| `Servo_05_FR_hip` | (110.0, -89.5, 175.0) | (-1, 0, 0) | -90…90 |
| `Servo_06_FR_knee` | (110.0, -89.5, 65.0) | (0, 1, 0) | -128…-65 |
| `Servo_07_BL_abduction` | (-129.0, 45.0, 175.0) | (1, 0, 0) | -30…30 |
| `Servo_08_BL_hip` | (-110.0, 89.5, 175.0) | (-1, 0, 0) | -90…90 |
| `Servo_09_BL_knee` | (-110.0, 89.5, 65.0) | (0, 1, 0) | -128…-65 |
| `Servo_10_BR_abduction` | (-129.0, -45.0, 175.0) | (1, 0, 0) | -30…30 |
| `Servo_11_BR_hip` | (-110.0, -89.5, 175.0) | (-1, 0, 0) | -90…90 |
| `Servo_12_BR_knee` | (-110.0, -89.5, 65.0) | (0, 1, 0) | -128…-65 |
| `Servo_13_spine_yaw` | (24.0, 0.0, 185.0) | (0, 0, 1) | -15…15 |
| `Servo_14_spine_pitch` | (-29.0, 0.0, 191.0) | (0, 1, 0) | -20…20 |
| `Servo_15_tail` | (-148.0, 0.0, 210.0) | (0, 1, 0) | -60…60 |
| `Servo_16_neck_pitch` | (120.0, 0.0, 234.0) | (0, 0, -1) | -30…45 |
| `Servo_17_neck_yaw` | (120.0, 0.0, 277.0) | (0, 0, 1) | -90…90 |
| `Servo_18_jaw` | (170.0, 0.0, 297.0) | (0, 0, -1) | 0…30 |
| `Servo_19_ear_L` | (150.0, 47.0, 334.0) | (0, 0, -1) | -45…45 |
| `Servo_20_ear_R` | (150.0, -47.0, 334.0) | (0, 0, -1) | -45…45 |

## IMU

| IMU | Звено | Положение (мир, покой), мм | От оси звена, мм |
|---|---|---|---|
| IMU_rear_MPU6050_0x68 | `Root` | (-58.4, -47.2, 154.7) | (+16.6, -47.2, -30.3) |
| IMU_front_MPU6050_0x69 | `Servo_13_spine_yaw` | (57.1, -0.2, 154.7) | (+33.1, -0.2, -30.3) |

Масса робота 2.672 кг, ЦМ в стойке (-2.9, +0.3, 183.5) мм. Стойка: бедро 46.6°, колено -88.4° (φ).

## Пружина колена (пружинный элемент сустава)

Торсион на каждом колене: жёсткость **0.5365 Н·м/рад**, свободное положение при κ = 40° (натяг 25° при κ 65°). Момент разгибает колено: τ = k·(κ − κ_free).

```xml
<joint name="knee" ... stiffness="0.5365" springref="-0.6981"/>
```
Кость колена φ = −κ, поэтому springref = −κ_free (рад). Демпфирование пружины не задаём.
