Dendy3CTD/NeuroPaw/weight_report.txt

╔══════════════════════════════════════════════════════════════╗
║            NeuroPaw — Таблица весов и нагрузки серв          ║
╚══════════════════════════════════════════════════════════════╝

── Геометрия стойки ──────────────────────────────────────────
  Высота спины от пола:             220 мм
  Центр корпуса от пола:            190 мм
  Высота шарнира бедра от пола:     160 мм
  Угол наклона бедра от вертикали:  35°
  Угол в колене:                    95°
  Позиция стопы (FL) X от плеча:   -40.9 мм

── Детали из PETG (заполнение 30%) ─────────────────────────────
  Корпус (shell, 5мм стенки)                196.1 г
  Бёдра PETG-трубки × 4                      32.9 г
  Голени PETG-трубки × 4                     35.8 г
  Кронштейны плеча × 4                        3.2 г
  Стопы TPU × 4:                             20.3 г
  ─────────────────────────────────────────────────────
  ИТОГО пластик:                            288.3 г

── Прочие компоненты ─────────────────────────────────────────
  Сервы MG996R × 12:                          660 г
  Батарея 2S 5000 мА·ч:                       270 г
  Электроника + провода (оценка):             150 г

  ══ ИТОГО:  1368 г (1.37 кг) ══

── Положение центра масс (оценка) ───────────────────────────
  X: ~0 мм  |  Y: ~0 мм  |  Z: ~180 мм от пола

── Проверка нагрузки MG996R (номинал 10.0 кг·см при 6В) ─────────
  Бедро:  ~3.08 кг·см  → 31% от номинала
  Колено: ~0.08 кг·см  → 1% от номинала

  Вывод: ✅ Запас по моменту достаточный
  При общем весе 1368 г бедренные сервы нагружены примерно
  на 31% — статическая стойка без проблем; динамика (ходьба)
  добавит ещё 1.5–2× нагрузку.
