Dendy3CTD/NeuroPaw/docs/engineering.md

# Инженерный расчёт NeuroPaw v6

Источник: `scripts/v6_calc.py` по модели `robodog_v6.blend`, поза «стоит».
Печать: PETG 1.27 г/см³, стенки 1.2 мм сплошные + заполнение 20%; TPU 95A для стоп. Перекрытия примитивов внутри детали считаются дважды (завышение ≈ 5–10 %).

## Масса: **2.67 кг** (цель ~2.3 кг)

| Группа | г |
|---|---:|
| Печать PETG | 976 |
| Сервоприводы | 890 |
| Питание (не закуплено) | 309 |
| Подшипники | 118 |
| Электроника | 98 |
| Провода | 83 |
| Оси M5 (болты + гайки) | 78 |
| Качалки, тяги, рычаги | 68 |
| Пружины колена | 32 |
| Печать TPU | 12 |
| Не в смете | 7 |
| Крепёж (распределён по деталям) | 0 |
| в т. ч. крепёж, распределён по печатным деталям | 70 |

## Центр масс (стойка): X = **-2.9**, Y = +0.3, Z = 183.5 мм
X = 0 — середина между осями бёдер (±110 мм), + к голове. В сцене маркер `CoM_marker`.

| Узел | Масса, г | X ЦМ, мм |
|---|---:|---:|
| Голова + шея (16→) | 295 | +148 |
| Передняя секция без ног | 450 | +97 |
| Задняя секция без ног и хвоста | 907 | -74 |
| Нога (одна, FL) | 251 | +86 |

## Запас по моменту

Полная таблица — `docs/servo_map.md`.
Все 20 суставов с запасом ≥ 1.5.

## Колено

`docs/knee_linkage.md`: передача 2.09 в стойке, ход κ 65…130°.

## Пружина колена (на всех 4 ногах)

Помогает разгибать колено (держит вес); при сгибании и в переносе ноги серва работает против неё. Подбор — `scripts/v6_knee_spring.py`: максимум наименьшего запаса по всем позам, проволока в пределах 0.6·Sut при κ 128°, витки не садятся на болт M5.

- Проволока пружинная (музыкальная, EN 10270-1 DH / ГОСТ 9389) **Ø2.0 мм**, Sut ≈ 2000 МПа.
- Наружный Ø **18 мм** (средний 16.0, внутренний 14.0), **6 рабочих витков**, длина тела 14.0 мм; ножки радиальные, 15 мм: одна — в паз чаши голени, вторая — в упор на щеке бедра.
- Жёсткость **536 Н·мм/рад** (5.47 кг·см/рад, 9.36 Н·мм/°).
- Натяг (предварительная закрутка) при κ = 65°: **25°** → момент 2.39 кг·см; при κ = 128° закрутка 88° → 8.40 кг·см (допускаемо 8.71 кг·см при 0.6·Sut); внутренний Ø при этом 13.4 мм.
- Навивка: **2 левые + 2 правые** — пружины левых и правых ног зеркальны (сгиб колена в мире одинаковый, а ось чаши смотрит в разные стороны). Пружина при сгибании должна закручиваться (витки сжимаются по диаметру).
- Навить самому: оправка Ø12.5 (пружинение раскроет до ≈ Ø14 внутр.), 6 витков вплотную, отпуск 250 °C 30 мин. Чаша голени: Ø22 снаружи, Ø18.6 внутри, глубина 15.

| Поза | κ, ° | Нагрузка в колене, кг·см | Пружина, кг·см | Передача | Запас без пружины | Запас с пружиной |
|---|---:|---:|---:|---:|---:|---:|
| стоит | 88 | 5.27 | 4.62 | 2.09 | 4.4 | **35.46** |
| рысь, 2 ноги ×1.3 | 88 | 13.71 | 4.62 | 2.09 | 1.7 | **2.53** |
| шаг, 3 ноги, стопа +40 мм | 85 | 13.20 | 4.29 | 2.14 | 1.8 | **2.64** |
| высокая стойка | 65 | 4.58 | 2.39 | 2.20 | 5.3 | **11.03** |
| встаёт (середина) ×1.3 | 115 | 6.58 | 7.16 | 2.07 | 3.5 | **39.36** |
| лежит | 128 | 4.82 | 8.40 | 4.76 | 10.9 | **14.64** |
| встаёт из «лежит» ×1.3 | 128 | 6.27 | 8.40 | 4.76 | 8.4 | **24.59** |
| сидит — задняя нога | 128 | 9.99 | 8.40 | 4.76 | 5.2 | **32.96** |
| сидит — передняя нога | 70 | 2.60 | 2.86 | 2.28 | 9.6 | **94.05** |
| перенос ноги, κ 65° | 65 | 0.00 ± 0.52 | 2.39 | 2.20 | 46.6 | **8.32** |
| перенос ноги, κ 70° | 70 | 0.00 ± 0.52 | 2.86 | 2.28 | 48.3 | **7.41** |
| перенос ноги, κ 75° | 75 | 0.00 ± 0.52 | 3.34 | 2.27 | 48.1 | **6.47** |
| перенос ноги, κ 80° | 80 | 0.00 ± 0.52 | 3.82 | 2.21 | 46.9 | **5.61** |
| перенос ноги, κ 85° | 85 | 0.00 ± 0.52 | 4.30 | 2.14 | 45.3 | **4.88** |
| перенос ноги, κ 90° | 90 | 0.00 ± 0.52 | 4.77 | 2.06 | 43.7 | **4.28** |
| перенос ноги, κ 95° | 95 | 0.00 ± 0.52 | 5.25 | 1.99 | 42.3 | **3.80** |
| перенос ноги, κ 100° | 100 | 0.00 ± 0.52 | 5.73 | 1.95 | 41.3 | **3.43** |
| перенос ноги, κ 105° | 105 | 0.00 ± 0.52 | 6.21 | 1.93 | 41.0 | **3.16** |
| перенос ноги, κ 110° | 110 | 0.00 ± 0.52 | 6.68 | 1.96 | 41.6 | **3.00** |
| перенос ноги, κ 115° | 115 | 0.00 ± 0.52 | 7.16 | 2.07 | 43.8 | **2.96** |
| перенос ноги, κ 120° | 120 | 0.00 ± 0.52 | 7.64 | 2.33 | 49.3 | **3.14** |

Наименьший запас с пружиной **2.53** (рысь, 2 ноги ×1.3); без пружины — 1.68 (рысь, 2 ноги ×1.3).

## Устойчивость (ЦМ над опорой из четырёх стоп)

| Поза | ЦМ X, мм | ЦМ Z, мм | До края опоры, мм |
|---|---:|---:|---:|
| стоит | -3 | 183 | **+89** |
| сидит | -114 | 164 | **+51** |

## Расход пластика

PETG в деталях 976 г (с крепежом); +15 % поддержки/кайма, +20 % перепечатка нагруженных деталей → **≈ 1.35 кг** (в смете 2 кг).
TPU (стопы, губы, зубы) 12 г — катушки 0.5 кг хватает с большим запасом.
