Dendy3CTD/NeuroPaw/docs/knee_linkage.md

# Колено: рычажная передача (четырёхзвенник)

Источник: `scripts/v6_knee_linkage.py`. Масса робота в расчёте — 2.3 кг (цель), момент MG996R 11.0 кг·см и 429°/с при 6 В.

## Схема

Серва колена стоит в бедре, вал в 40 мм от оси бедра, ось колена в 110 мм.
Качалка r1 соединена с рычагом r2 на голени тягой L на двух шаровых наконечниках M3.
κ — сгибание колена (0 = прямая нога, колено назад), β — угол рычага от поперечной оси голени при κ = 0, α — угол качалки от положения при κ = 65°.

**Выбранная геометрия (B):** r1 = 15 мм, r2 = 29 мм, тяга L = 55 мм (между центрами шаров), рычаг повёрнут на β = 38° от оси голени, вал сервы на оси бедра (u_s = 0).

- Ход колена **κ = 65…130°** (65°) при ходе сервы **155°** (лимит 170°: импульс 500–2500 мкс).
- Передача в зоне стойки и шага (κ 75–110°): **≥ 1.93**, в стойке (κ = 88°): **2.09**.
- Угол передачи на всём ходе ≥ 31° (требование ≥ 30°), тяга не подходит к осям ближе 6 мм.

## Сравнение вариантов (ход ↔ передача)

| Вариант | Ход κ | Мин. передача в стойке/шаге | Геометрия r1/r2/L |
|---|---|---:|---|
| B — выбран: 65…130° | 65–130° | 1.93 | 15/29/55 мм |
| A — только стойка/шаг: 65…110° | 65–110° | 2.01 | 15/30/54 мм |
| C1 — до 140° | 65–140° | 1.66 | 15/25/59 мм |
| C2 — до 145° (сидит по-собачьи), качалка 18 мм | 60–145° | 1.46 | 18/27/74 мм |

## Таблица хода (шаг 5°)

| κ, ° | α сервы, ° | Передача | Угол передачи, ° | Скорость колена, °/с |
|---:|---:|---:|---:|---:|
| 65 | +0.0 | 2.20 | 31 | 195 |
| 70 | -11.2 | 2.28 | 41 | 188 |
| 75 | -22.6 | 2.27 | 50 | 189 |
| 80 | -33.8 | 2.21 | 59 | 194 |
| 85 | -44.7 | 2.14 | 67 | 200 |
| 90 | -55.2 | 2.06 | 74 | 208 |
| 95 | -65.4 | 1.99 | 81 | 215 |
| 100 | -75.2 | 1.95 | 87 | 220 |
| 105 | -84.9 | 1.93 | 88 | 222 |
| 110 | -94.6 | 1.96 | 84 | 218 |
| 115 | -104.7 | 2.07 | 80 | 207 |
| 120 | -115.5 | 2.33 | 77 | 184 |
| 125 | -128.6 | 3.06 | 75 | 140 |
| 130 | -155.5 | 10.55 | 77 | 41 |

## Позы «лежит», «встаёт», «сидит»

Проверено на модели (`scripts/v6_poses.py`): пересечений нет, тяга замкнута.

- **«Лежит» = нижнее положение**: бедро 90° (горизонтально назад), колено 130°, ось бедра 102 мм, живот **77 мм над полом**.
- **Лечь животом на пол нельзя**: нужно бедро ≈ 150° (стопа позади бедра, колено вверх-назад). Таблица даёт ±90°, а механически при ≈ 138° коленная серва упирается в серву бедра.
  Если живот на полу обязателен: сместить ноль бедра (ход −30…+150°) и опустить коленную серву в бедре на ~12 мм (новый расчёт рычагов), перенести верхнюю планку кронштейна.
- **«Встаёт»** начинается из нижнего положения: передача у κ = 130° ≈ 10 (рядом с мёртвой точкой качалки), колено медленное (~40°/с), но момент с большим запасом.
- **«Сидит»**: задние ноги в нижнем положении (ось бедра 102 мм), передние в высокой стойке (204 мм) → наклон корпуса ≈ 28°, плюс позвоночник до 20°. Таз до пола не достаёт (~70 мм).
- ⚠ У κ = 130° качалка почти на одной линии с тягой: нужен **механический упор на 131–132°**, иначе при падении механизм может проскочить мёртвую точку и вывернуться.

## Запас по моменту колена (MG996R 11.0 кг·см)

| Поза | κ, ° | Плечо, мм | Момент в колене, кг·см | Передача | Запас |
|---|---:|---:|---:|---:|---:|
| стоит, 4 ноги | 88 | 80 | 4.6 | 2.09 | 5.0 |
| рысь, 2 диагональные ноги | 88 | 80 | 9.2 | 2.09 | 2.5 |
| рысь, ×1.3 динамика | 88 | 80 | 12.0 | 2.09 | 1.9 |
| шаг, 3 ноги, стопа вынесена на 40 мм | 85 | 97 | 11.4 | 2.14 | 2.1 |
| высокая стойка (бедро 200 мм) | 69 | 65 | 3.7 | 2.27 | 6.7 |
| встаёт из «лежит» (бедро 90°, живот 77 мм над полом), ×1.3 | 130 | 77 | 5.8 | 10.55 | 20.2 |
| лежит (нижнее положение) | 130 | 77 | 4.4 | 10.55 | 26.2 |
