Dendy3CTD/NeuroPaw/analysis_v2.md

# NeuroPaw — анализ robodog_v2.blend (Этап 1)

Скрипты: `scripts/01_analyze_scene.py` (инвентаризация), `scripts/render_views.py -- v2` (рендеры).
Сырой вывод: `analysis_v2_raw.txt`. Рендеры: `renders/v2_{front,side,top,iso}.png`.

## Состав сцены
- 78 объектов, 5 коллекций: Body (2), Electronics (6), Legs (28), Axes (24), Labels (18).
- Нет камеры, света, арматуры. Движок EEVEE. Единицы: метры, scale_length = 1.
- `dim_*` (6 шт.) и `lbl_*` (12 шт.) — это 3D-текст (FONT), а не размерные линии; `ax_*` — стрелки осей суставов.
  Все они служебные, физической геометрии не имеют.
- Electronics: Battery_2S 140×45×25 (низ корпуса), ESP32-S3 56×28×10, PCA9685 60×25×5, UBEC 50×30×15,
  IMU 20×20×5 (стопкой под крышкой), VL53L5CX 10×10×3 (вынесен перед мордой).
  Всё — кубы 6 полигонов с неприменённым масштабом. Пересечений внутри корпуса нет.

## Проблемы
1. **Неприменённый масштаб**: все кубы (корпус, 12 серв, 4 кронштейна, 6 плат) имеют scale = габарит, mesh 1×1×1.
2. **Ориентация серв не совпадает с осями суставов**: у всех 12 серв ось вала (сторона 42.9 мм) смотрит вверх (Z),
   а оси суставов — X (плечо) и Y (бедро, колено). Сервы просто поставлены кубом в точку сустава.
3. **Сервы пересекаются**: плечевая и бедренная сервы каждой ноги перекрываются на 4.5×12.9×19.7 мм;
   плечевые сервы наполовину сидят внутри корпуса (как сплошного блока).
4. **Звенья не соединены с осями**: бедро и голень — трубки Ø14 мм, начинающиеся из центра коробки сервы,
   а не от вала; кронштейн плечо→бедро — плашка 13×36×8, висящая между сервами и не связанная с осью плеча.
   Визуально голень «торчит» из куба коленной сервы — отсюда впечатление, что она висит в воздухе.
5. **Разная ориентация ног**: колени передних ног вынесены вперёд (+168 мм, за пределы корпуса), задних — назад,
   стопы подведены внутрь (±64 мм). Получилась стойка «><», а не однонаправленные колени, как у Spot Micro.
6. **Коленная серва на колене**: 55 г на конце бедра, большая инерция ноги. У Spot Micro коленная серва стоит
   у бедра и двигает голень тягой.
7. **Нет иерархии и pivot**: родителей нет, origin звеньев в середине трубок; рига нет.
8. **Корпус** — сплошной прозрачный куб 6 полигонов: нет стенок, крышки, фасок, креплений серв.
9. **Головы нет**; VL53L5CX висит в воздухе перед корпусом.
10. **Материалы есть, но заглушки**: 10 штук (PETG прозрачный 40 %, красные сервы и т. д.), не презентационные.
11. **Ошибка в weight_report.txt**: момент на колене 0.08 кг·см неверен. Статически при массе 1.37 кг
    на ногу ~0.34 кг: колено ≈ 0.34 × 10.4 см ≈ **3.6 кг·см**, бедро ≈ 0.34 × 4.1 см ≈ **1.4 кг·см**
    (в отчёте наоборот: 3.08 и 0.08). Запас у MG996R всё равно есть, но в динамике колено — самый нагруженный сустав.
12. Габариты сборки: 356 × 224 × 220 мм (X × Y × Z), стопы на Z = 0.

## Решения для v3 (согласовано 2026-10-27)
- Сервы: MG996R (40.7×19.7×42.9 мм), 12 шт.
- Коленная серва стоит у бедра, голень приводится тягой (схема Spot Micro).
- Все колени смотрят назад.
- В корпусе место только под ESP32-S3 + PCA9685 + UBEC + IMU + 2S; габарит 260×110×60 мм сохраняется.
- Голова статичная: камера IMX219, VL53L5CX, посадки под глаза GC9A01.
