Dendy3CTD/NeuroPaw/renders/front.png

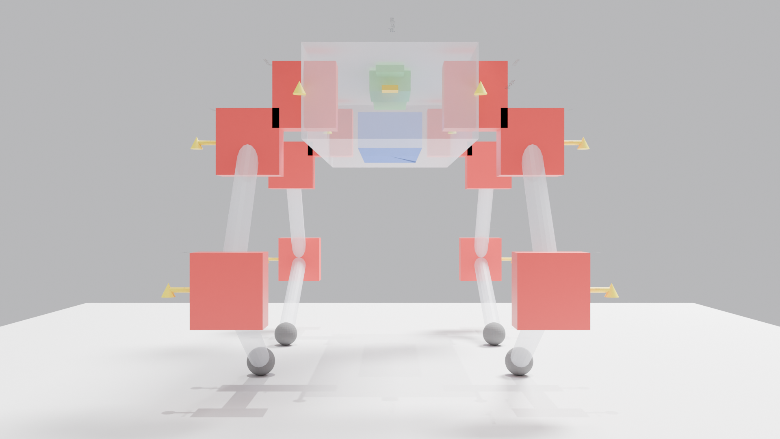
renders/front.png
