Dendy3CTD/NeuroPaw/renders/side.png

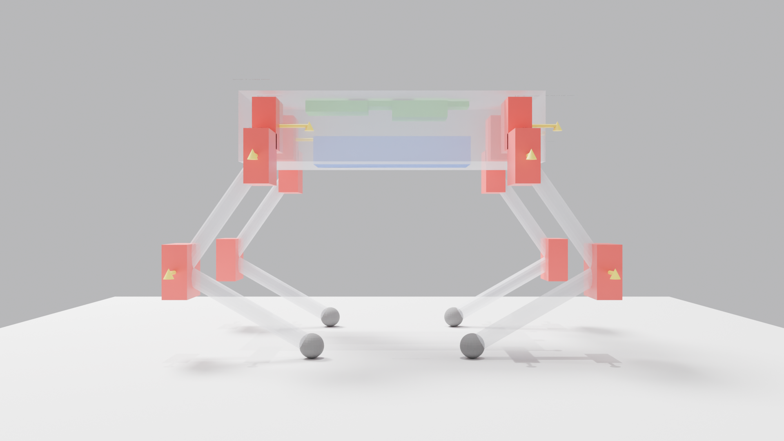
renders/side.png
