Dendy3CTD/NeuroPaw/renders/top.png

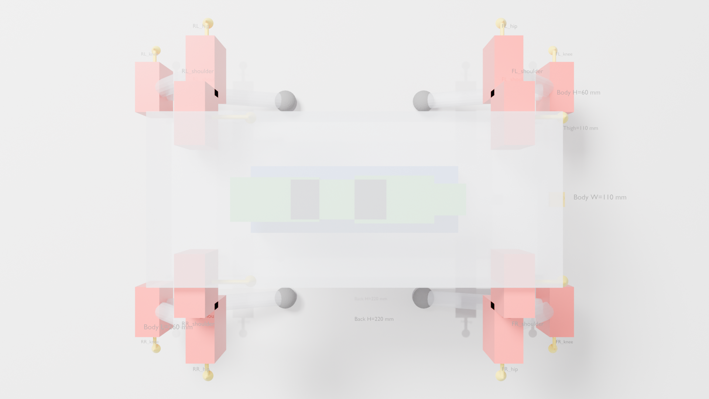
renders/top.png
