Dendy3CTD/NeuroPaw/renders/v2_front.png

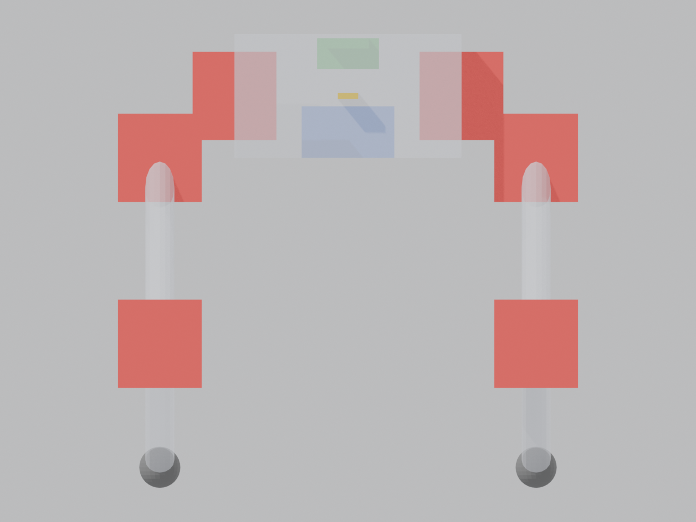
renders/v2_front.png
