Dendy3CTD/NeuroPaw/renders/v2_side.png

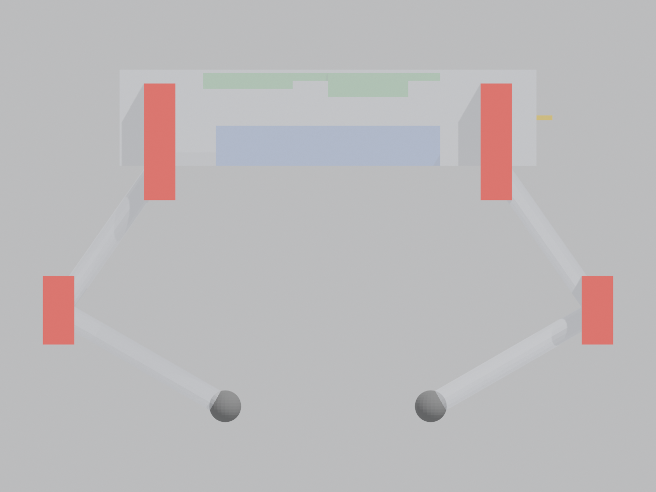
renders/v2_side.png
