Dendy3CTD/NeuroPaw/renders/v2_top.png

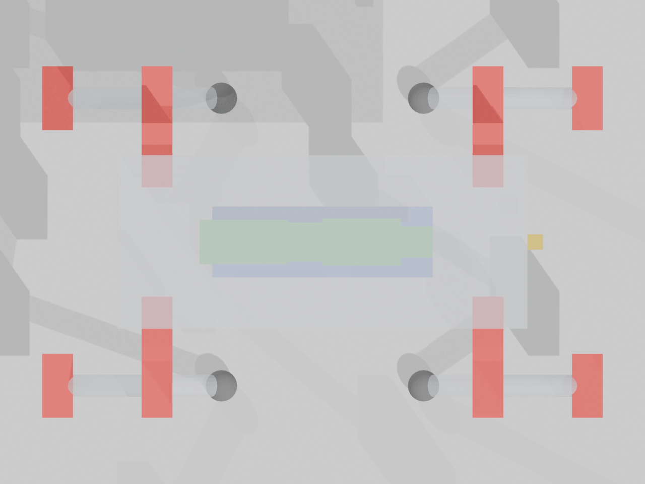
renders/v2_top.png
