Dendy3CTD/NeuroPaw/renders/v3_front.png

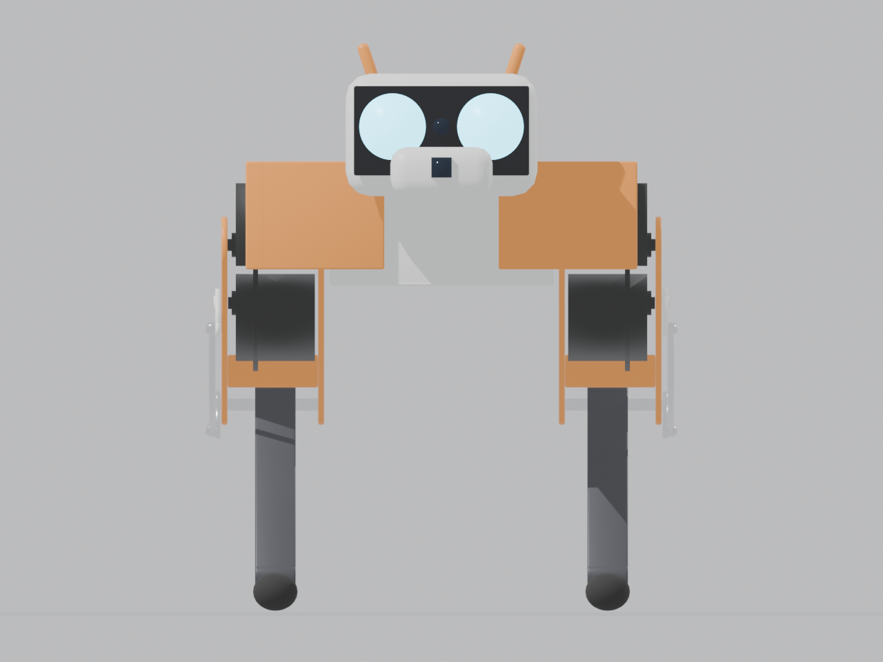
renders/v3_front.png
