Dendy3CTD/NeuroPaw/renders/v3_side.png

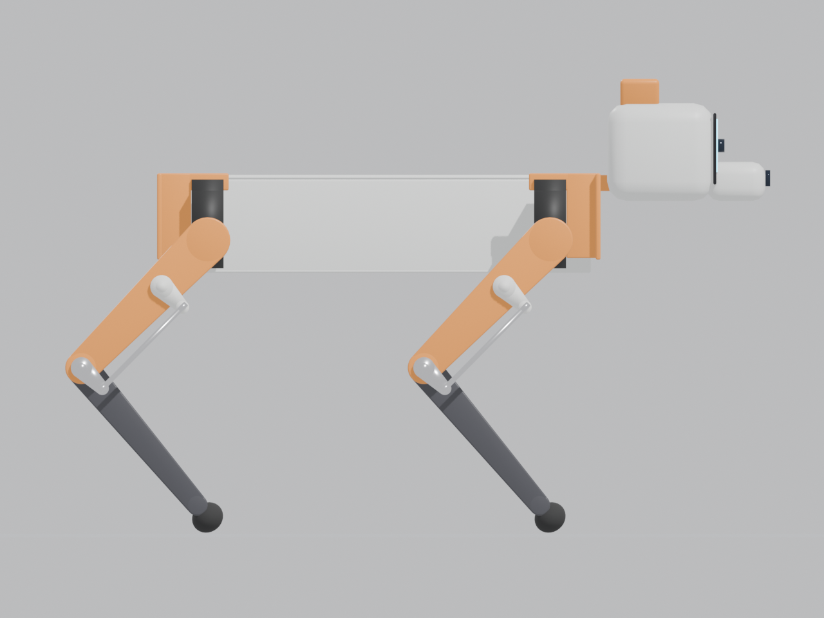
renders/v3_side.png
