Dendy3CTD/NeuroPaw/renders/v3_top.png

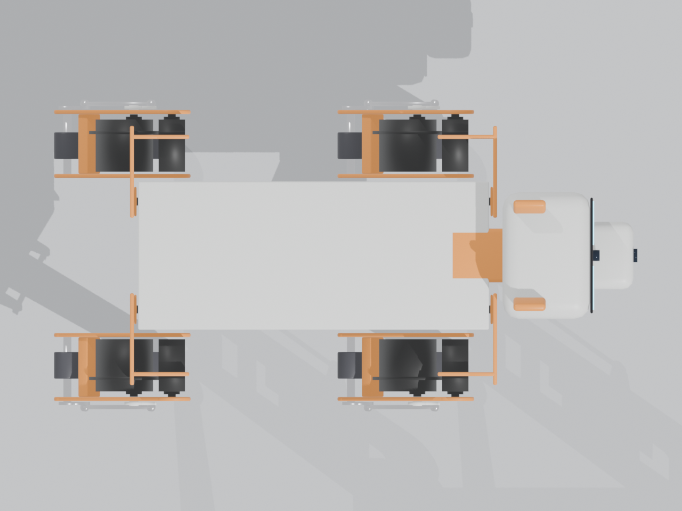
renders/v3_top.png
