Dendy3CTD/NeuroPaw/renders/v6_poses_lie.png

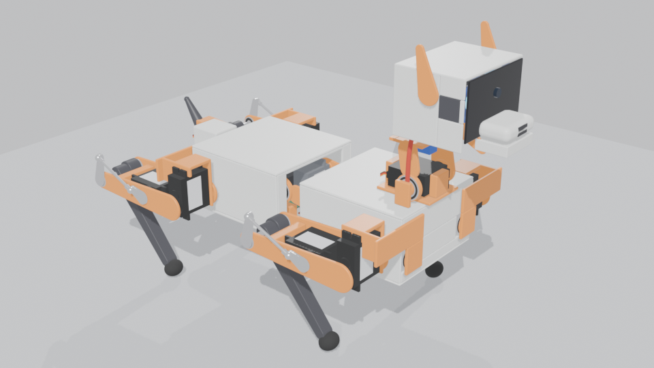
renders/v6_poses_lie.png
