Dendy3CTD/NeuroPaw/renders/v6_rear_top.png

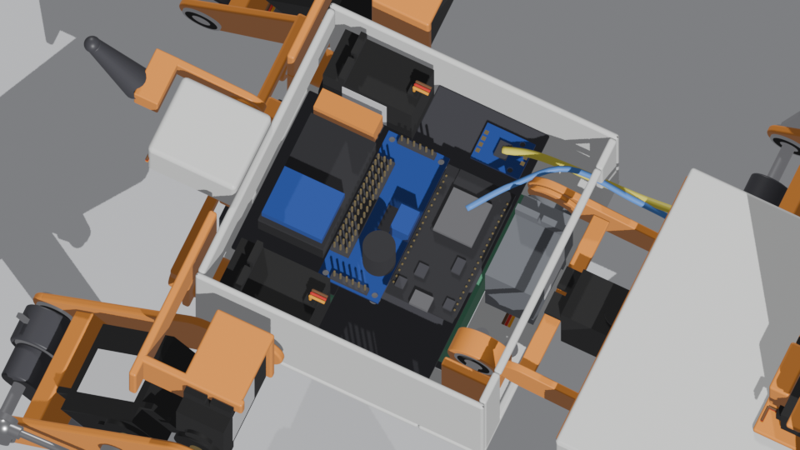
renders/v6_rear_top.png
