Dendy3CTD/NeuroPaw/renders/v6_s1_front.png

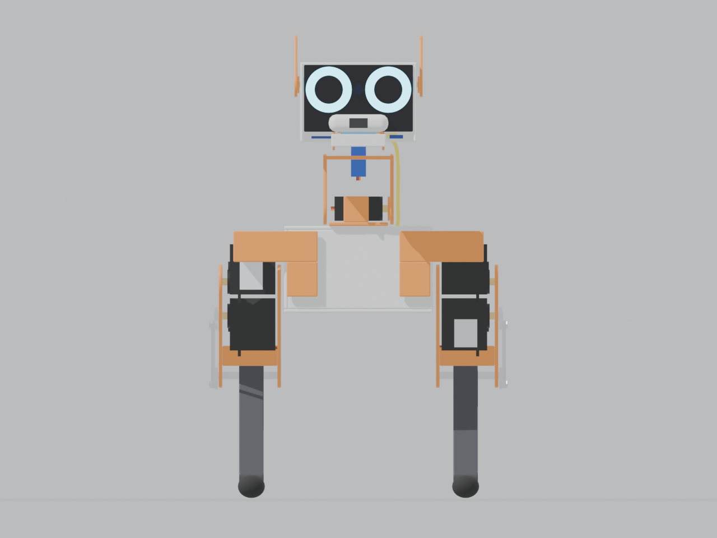
renders/v6_s1_front.png
