Dendy3CTD/NeuroPaw/renders/v6_s1_iso.png

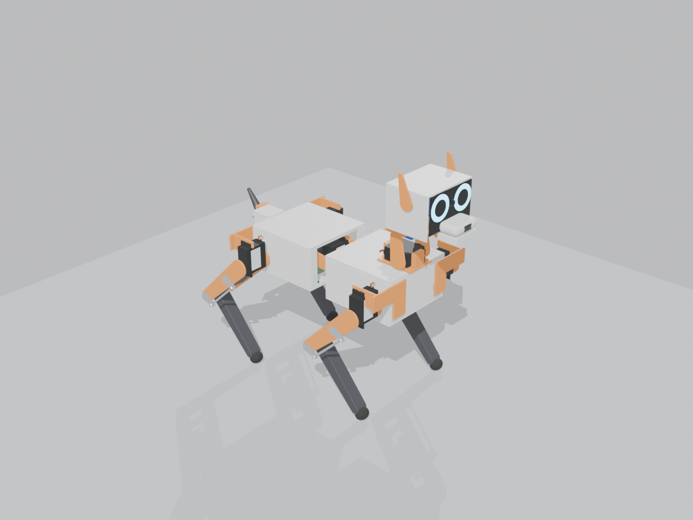
renders/v6_s1_iso.png
