Dendy3CTD/NeuroPaw/renders/v6_s1_side.png

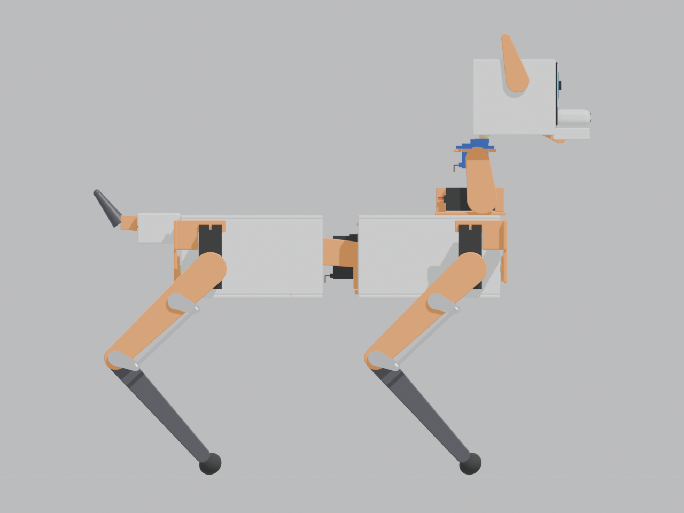
renders/v6_s1_side.png
