Dendy3CTD/NeuroPaw/renders/v6_s1_top.png

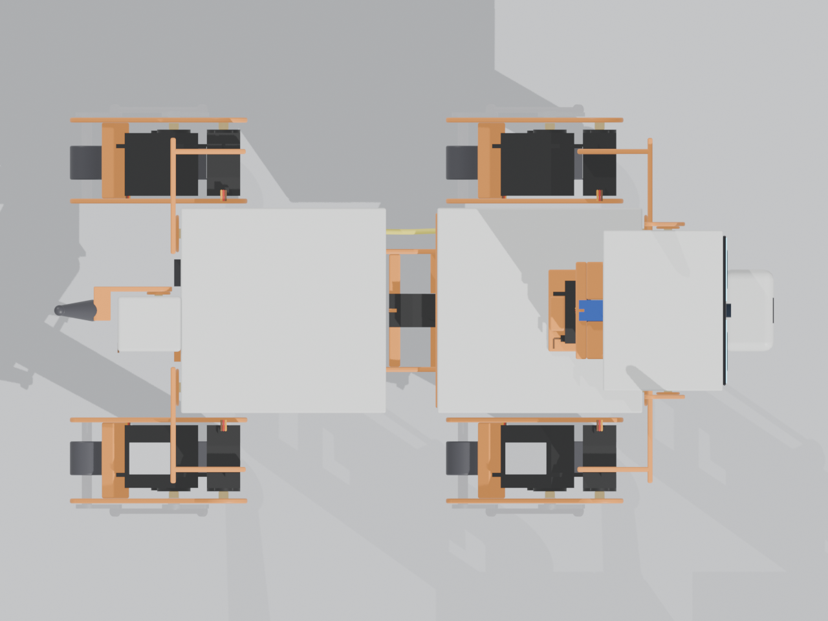
renders/v6_s1_top.png
