Dendy3CTD/NeuroPaw/renders/v6_servo_map_back.png

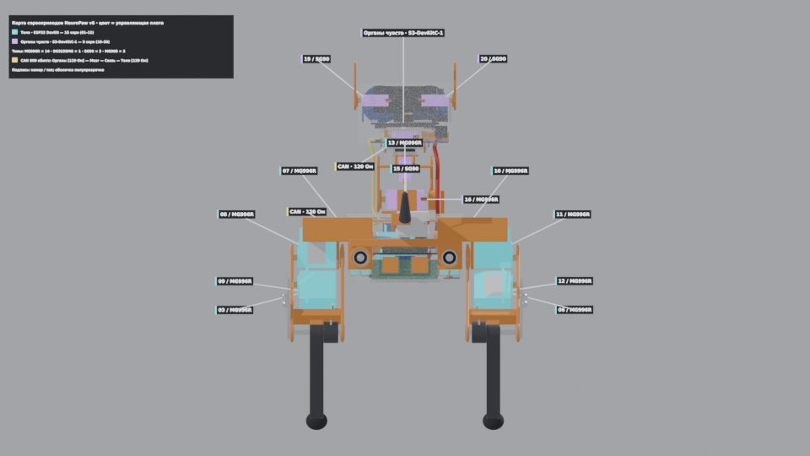
renders/v6_servo_map_back.png
