Dendy3CTD/NeuroPaw/renders/v6_servo_map_front.png

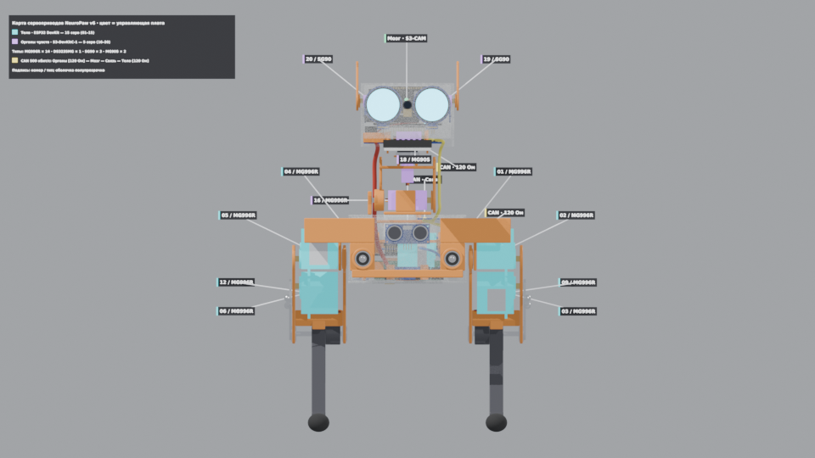
renders/v6_servo_map_front.png
