Dendy3CTD/NeuroPaw/renders/v6_servo_map_top.png

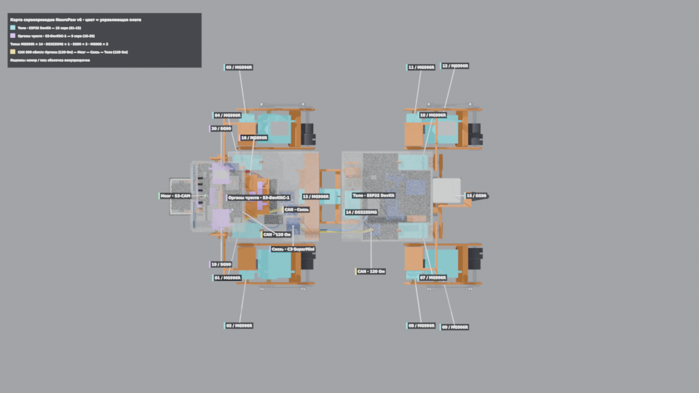
renders/v6_servo_map_top.png
