Dendy3CTD/NeuroPaw/renders/v6_servo_types.png

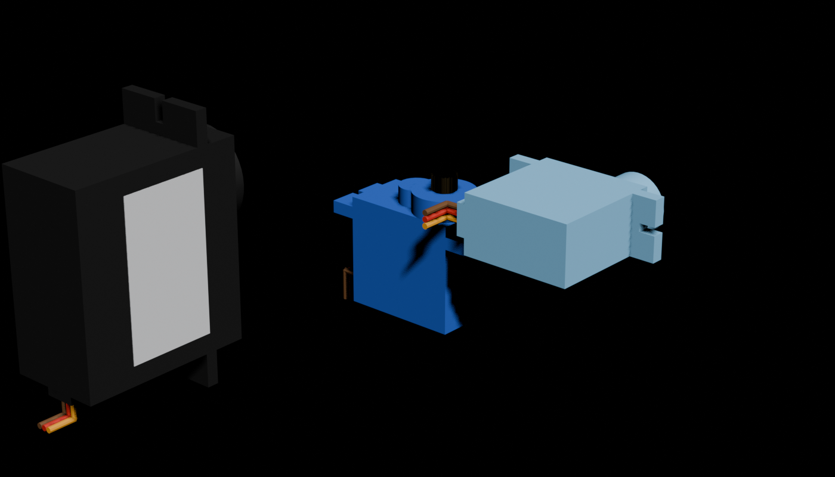
renders/v6_servo_types.png
