Dendy3CTD/NeuroPaw/docs/bom.md

# Список покупок NeuroPaw v6

Всё, что нужно купить для сборки, и где каждая позиция стоит в модели. Генератор — `scripts/v6_docs.py`.

| № | Позиция | Модель / описание | Для чего | Ед. | Кол-во | В модели |
|---:|---|---|---|---|---:|---|
| | **Сервоприводы** | | | | | |
| 1 | Сервопривод | MG996R | Ноги ×12 (колени через тягу), наклон шеи, позвоночник вбок | шт. | 14 | 14: `Servo_01…13, 16` |
| 2 | Сервопривод | DS3235MG | Позвоночник вверх-вниз | шт. | 1 | `Servo_14_spine_pitch` |
| 3 | Сервопривод | MG90S | Поворот шеи, челюсть | шт. | 2 | `Servo_17_neck_yaw`, `Servo_18_jaw` |
| 4 | Сервопривод | SG90 | Уши ×2, хвост | шт. | 3 | `Servo_15_tail`, `Servo_19/20_ear` |
| | **Платы и связь** | | | | | |
| 5 | Плата «Тело» | ESP32 DevKit CH340 (ESP32-WROOM-32) | Ходьба, баланс, датчики | шт. | 1 | `ESP32_Body` |
| 6 | Плата «Органы чувств» | ESP32-S3-DevKitC-1 N16R8 | Голос, глаза, касания, сервы головы | шт. | 1 | `ESP32_Senses` |
| 7 | Плата «Мозг» | ESP32-S3-CAM (N16R8) + камера | Зрение, память, решения | шт. | 1 | `ESP32_Brain` за глазами + `Camera_OV2640` на штатном шлейфе |
| 8 | Плата «Связь с миром» | ESP32-C3 SuperMini | Wi-Fi, облачная LLM | шт. | 1 | `ESP32_Comms` |
| 9 | Модуль CAN | SN65HVD230, набор 4 шт. | Связь между платами | набор | 1 | 4: `CAN_transceiver_*` |
| 10 | Драйвер серв | PCA9685 + тестер сервоприводов | 15 серв «Тела», проверка серв | набор | 1 | `PCA9685_Body` (тестер — для проверки серв) |
| | **Датчики** | | | | | |
| 11 | Гироскоп + акселерометр | GY-521 MPU-6050 | Передний IMU | шт. | 1 | `IMU_front_MPU6050_0x69` |
| 12 | Гироскоп + акселерометр | Имеется | Задний IMU | шт. | 1 | `IMU_rear_MPU6050_0x68` (принят GY-521) |
| 13 | Ультразвуковой датчик | HC-SR04 (имеется) | Препятствия, стены | шт. | 1 | `Sonar_HCSR04` |
| 14 | Датчик тока | INA226 | Ток челюсти (хват) | шт. | 1 | `INA226_jaw` |
| | **Звук, глаза, память** | | | | | |
| 15 | Микрофон | INMP441, набор 2 шт. | Уши: команды, направление звука | набор | 1 | `Mic_INMP441_L/R` |
| 16 | Экран | GC9A01 1,28", 240×240, SPI | Глаза | шт. | 2 | `Eye_L/R_GC9A01` |
| 17 | Усилитель | MAX98357A, I2S, 3 Вт | Голос | шт. | 1 | `Amp_MAX98357A` |
| 18 | Динамик | 35×25 мм, 4 Ом, 3 Вт, набор 2 шт. | Голос (1 запасной) | набор | 1 | 1: `Speaker_35x25` (второй — запас) |
| 19 | Флешка | 50 ГБ (имеется) | Долгая память | шт. | 1 | `USB_flash_50GB` |
| 20 | OTG-переходник | USB-C → USB-A | Подключение флешки к «Мозгу» | шт. | 1 | в голову не помещается (69 мм) — для отладки на столе; в голове — гибкий OTG-кабель |
| | **Механика** | | | | | |
| 21 | Подшипник | 625ZZ, набор 10 шт. | Суставы ног, позвоночник, шея (нужно 24) | набор | 3 | 22 в модели + 2 запас = 24 из 30 |
| 22 | Подшипник | MR683ZZ, набор 2 шт. | Челюсть | набор | 1 | 2: `Jaw_bearing_*_MR683` |
| 23 | Упорный подшипник | 51100, набор 2 шт. | Поворот шеи | набор | 1 | 1: `Neck_bearing_yaw_51100` (второй — запас) |
| 24 | Крепёж и мелочи | Болты/гайки M5, тяги M3, шаровые M3 × 8, винты, вставки, фиксатор резьбы | Сборка | компл. | 1 | оси M5 × 15, тяги M3 × 4 + 8 шаровых, термовставки |
| 25 | Качалка серво | Металлическая 25T | Ноги, позвоночник, шея, тяги колена | шт. | 16 | 15 (11 + 4 качалки тяг колена) + 1 запас |
| 26 | Пластик | PETG 1,75 мм | Корпус, ноги, голова | кг | 2 | печать ≈ 1.35 кг с поддержками и перепечаткой |
| 27 | Пластик | TPU 1,75 мм, катушка 0,5 кг | Лапы, губы и зубы | катушка | 1 | стопы, губы, зубы ≈ 12 г |

## Проверка количеств

- **Качалки 25T:** 15 (все MG996R и DS3235MG, на тягах колена тоже металлические) + 1 запас = 16.
- **625ZZ:** 22 в модели (отведение 4, бедро 4, колено 8, позвоночник 2 + 2, наклон шеи 2) + 2 запас = 24; куплено 30.
- **MR683ZZ:** 2 из 2. **51100:** 1 из 2. **Динамик:** 1 из 2. **SN65HVD230:** 4 из 4. **INMP441:** 2 из 2.
- **PETG:** детали ≈ 0.98 кг, с поддержками (+15 %) и перепечаткой (+20 %) ≈ 1.35 кг — 2 кг хватает. **TPU:** ≈ 12 г из 500.

## Дополнительно (докупить)

| Позиция | Кол-во | Зачем |
|---|---|---|
| Гибкий OTG-кабель: угловой USB-C → гнездо USB-A, 10 см | 1 | жёсткий переходник с флешкой (69 мм) в голову не помещается |
| Резисторы: делитель Echo HC-SR04 1 к + 2 к, делитель батареи 100 к + 33 к, подтяжка OE 10 к | набор | Echo 5 В → 3.3 В; напряжение батареи на АЦП «Тела» |
| Удлинители серв 20–30 см | 7 | передние ноги 01–06 и позвоночник 13 → PCA9685 в задней секции |
| Торсионные пружины колена: проволока Ø2.0 мм, OD 18.0 мм, 6 витков (2 левые + 2 правые) | 4 | или навить самому из проволоки Ø2.0 мм — `engineering.md` |
| Гнёзда PBS 1×19 (ложемент «Тела») | 2 | у DevKit 38 выводов нет крепёжных отверстий |

## Питание (схема в `power.md`, объекты в модели — `purchased = False`)

- Molicel P28A 18650 × 4 (2S2P 5600 мА·ч)
- BMS 2S 40 А
- UBEC 6 В 20 А × 2 (передняя и задняя ветки)
- DC-DC 7.4 → 5 В 5 А (Mini560 Pro)
- Предохранители 40 / 25 / 25 / 5 А + держатели mini-blade
- P-MOSFET ключи веток × 4 (мягкий старт)
- Конденсаторы 2200 мкФ 10 В Low-ESR × 3
- XT60 гнездо + XT60 loop-key (главный выключатель)
- Зарядка 2S, контакты док-станции (место в дне задней секции), блок питания 12 В
- Провода — имеются
