Dendy3CTD/NeuroPaw/meshes/body.stl

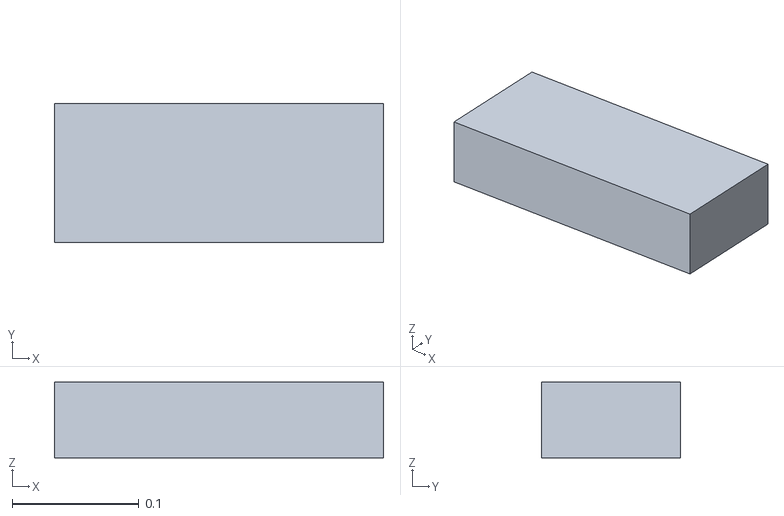
[picture p35: CAD file, 2026-10-28]
meshes/body.stl
0.26 x 0.11 x 0.06
