Dendy3CTD/NeuroPaw/meshes/servo_mg996r.stl

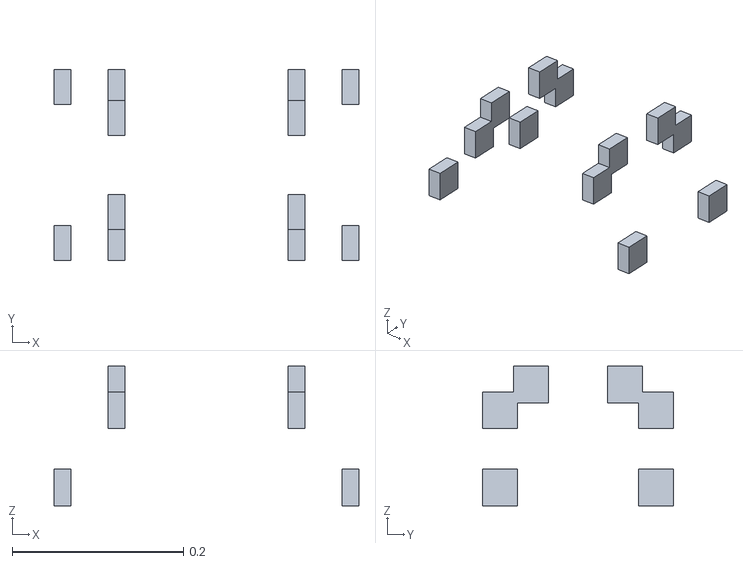
[picture p36: CAD file, 2026-10-28]
meshes/servo_mg996r.stl
0.356 x 0.223 x 0.163
