Dendy3CTD/NeuroPaw/meshes/foot.stl

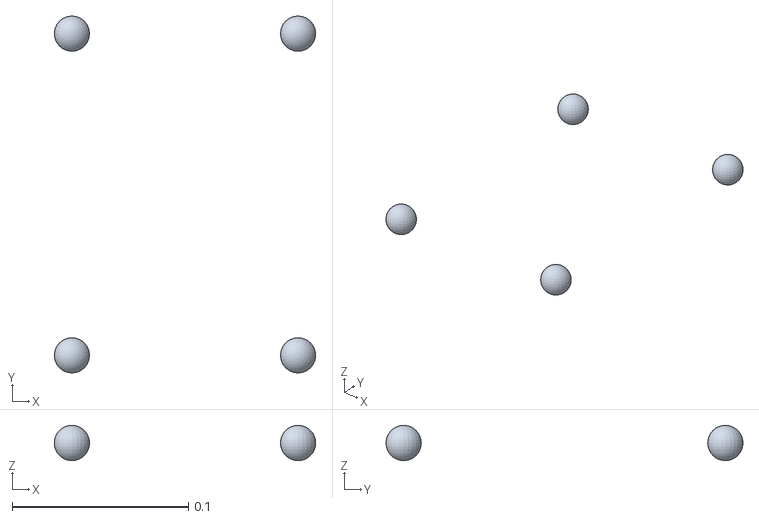
[picture p37: CAD file, 2026-10-28]
meshes/foot.stl
0.148 x 0.202 x 0.02
