Dendy3CTD/NeuroPaw/meshes/thigh.stl

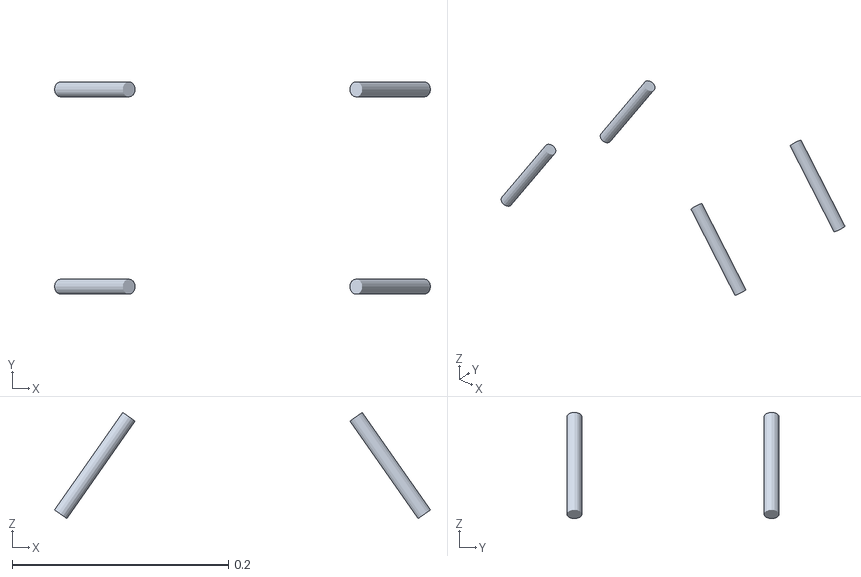
[picture p38: CAD file, 2026-10-28]
meshes/thigh.stl
0.348 x 0.196 x 0.0981
