Dendy3CTD/NeuroPaw/meshes/shin.stl

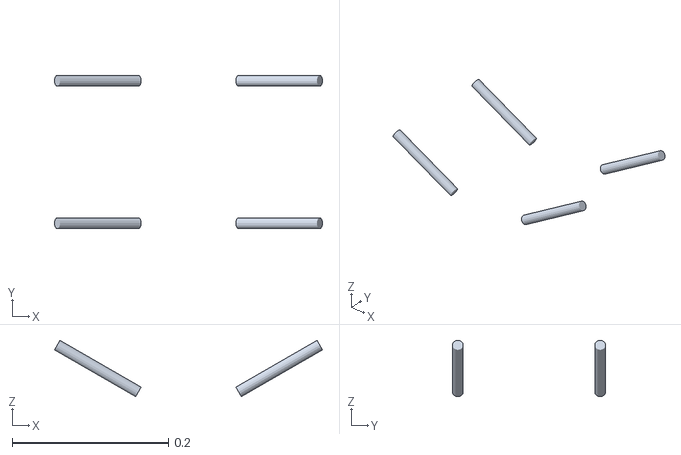
[picture p39: CAD file, 2026-10-28]
meshes/shin.stl
0.343 x 0.196 x 0.072
