Dendy3CTD/NeuroPaw/(list of files, cad)

Other CAD files:
robodog_v2.blend
robodog_v3.blend
robodog_v6.blend
